eSpark-Consulting-Group/johncox-fmmdesign/docs/Client-Files/Enclosure-Catalogs/Baxin Catalog Pg 1.jpg

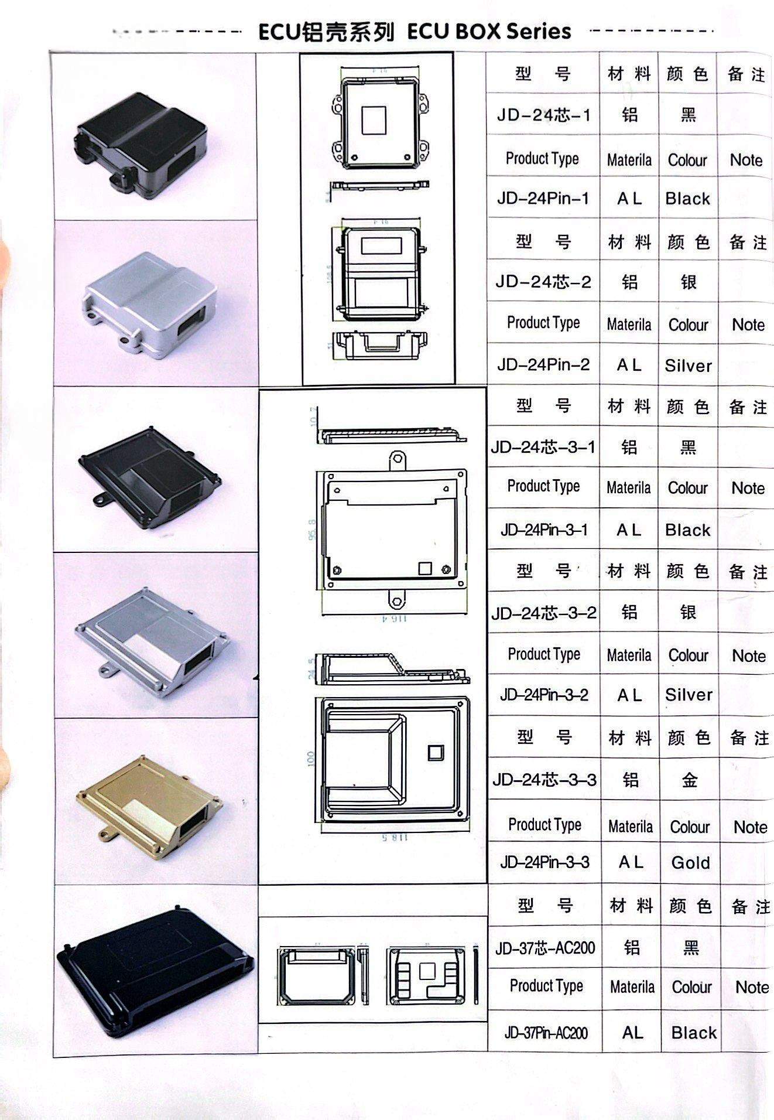
docs/Client-Files/Enclosure-Catalogs/Baxin Catalog Pg 1.jpg
