eSpark-Consulting-Group/johncox-fmmdesign/docs/Dev-Files/FMM-Connector-Format/FMM Pinout Format.docx

Sensor / Purpose | Circuit Type | Pin
Fuel Flow Sensor Engine 1 Supply | +5v power | 23
| Flow signal | 24
| Temp signal | 25
| Ground | 26
Fuel Flow Sensor Engine 1 Return | +5v power | 27
| Flow signal | 28
| Temp signal | 29
| Ground | 30
Fuel Flow Sensor Engine 2 Supply | +5v power | 31
| Flow signal | 32
| Temp signal | 33
| Ground | 34
Fuel Flow Sensor Engine 2 Return | +5v power | 36
| Flow signal | 37
| Temp signal | 38
| Ground | 39
Tank Level Sensor 1 | Level Signal | 14
| GND | 15
Tank Level Sensor 2 | Level Signal | 16
| GND | 17
Tank Level Sensor 3 | Level Signal | 18
| GND | 19
Tank Level Sensor 4 | Level Signal | 20
| GND | 21
System Power | +12v | 1
| +12v | 2
| GND | 3
| GND | 4
USB Connections | VBUS | 6
| USB-P | 7
| USB-N | 8
| GND | 9
CAN Connections | CAN-P | 11
| CAN-N | 12
| IS-GND (Isolated) | 13
