eSpark-Consulting-Group/johncox-fmmdesign/Design-Files/FMM-v1.0/Renderings/2D_C_View.PNG

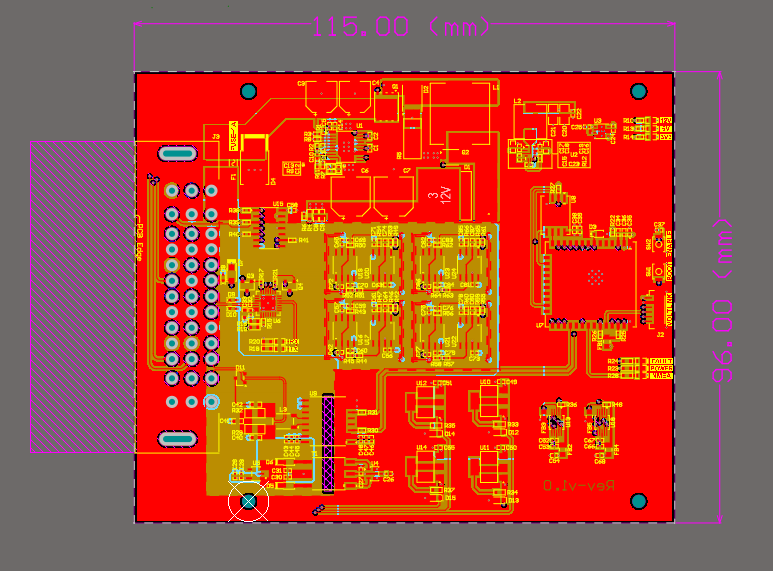
Design-Files/FMM-v1.0/Renderings/2D_C_View.PNG
