eSpark-Consulting-Group/johncox-fmmdesign/Design-Files/FMM-v1.0/Renderings/2D_Power_Layer.png

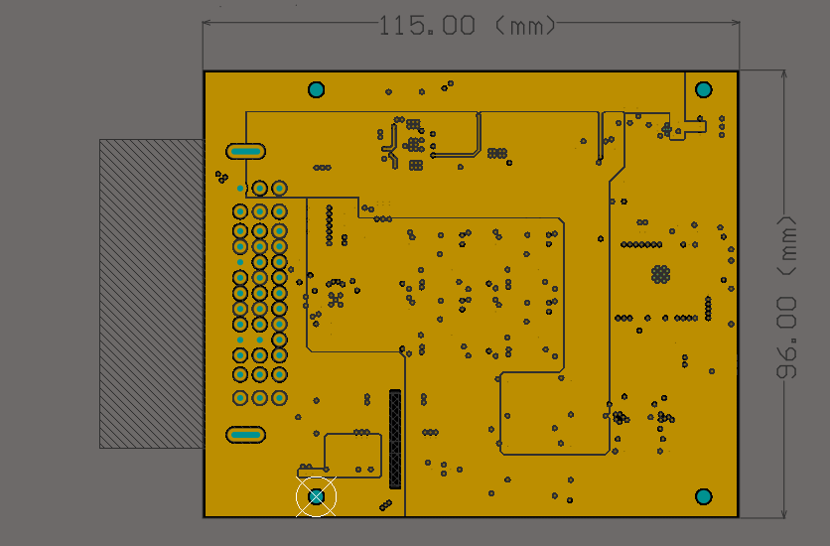
Design-Files/FMM-v1.0/Renderings/2D_Power_Layer.png
