eSpark-Consulting-Group/johncox-fmmdesign/Design-Files/FMM-v1.0/Renderings/2D_Top_Layer.PNG

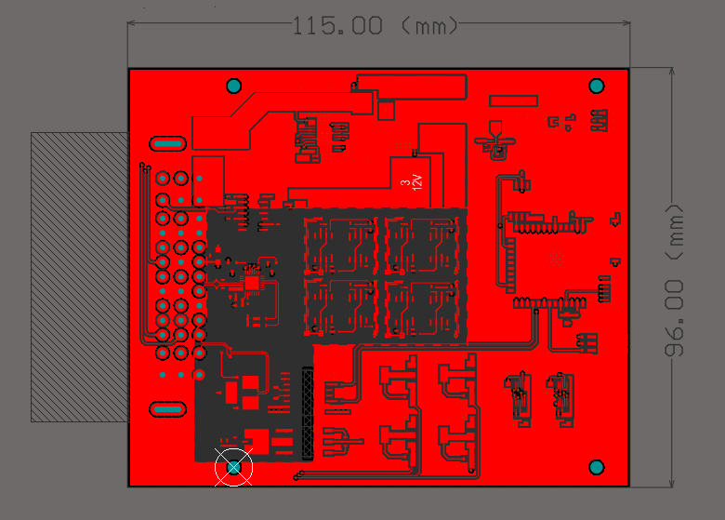
Design-Files/FMM-v1.0/Renderings/2D_Top_Layer.PNG
