eSpark-Consulting-Group/johncox-fmmdesign/Design-Files/FMM-v1.0/Renderings/3D_Bottom_View.PNG

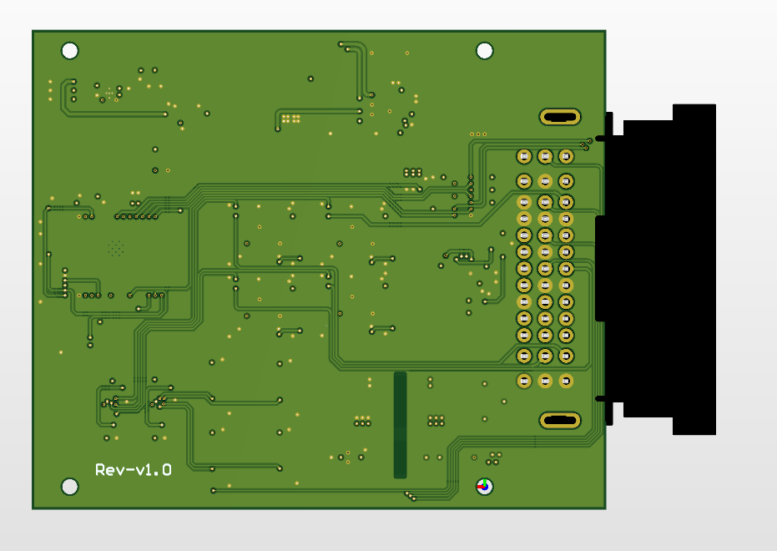
Design-Files/FMM-v1.0/Renderings/3D_Bottom_View.PNG
