eSpark-Consulting-Group/johncox-fmmdesign/docs/Dev-Files/Enclosure Files/Enclosure-PCB-Updated.png

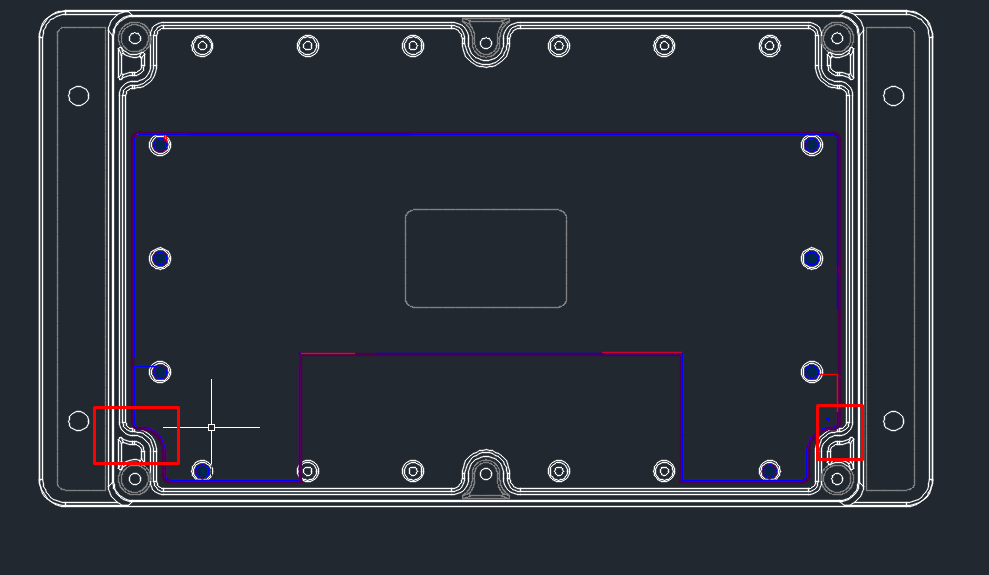
docs/Dev-Files/Enclosure Files/Enclosure-PCB-Updated.png
