eSpark-Consulting-Group/johncox-fmmdesign/docs/Dev-Files/Enclosure Files/imgpsh_fullsize_anim (2).png

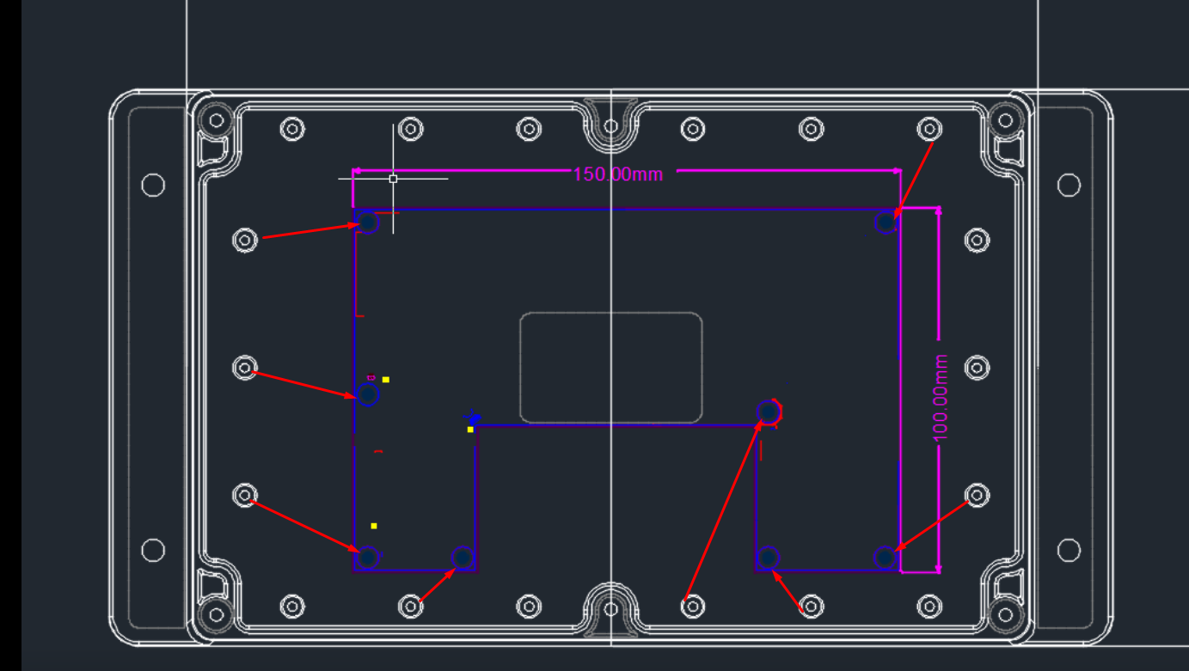
docs/Dev-Files/Enclosure Files/imgpsh_fullsize_anim (2).png
