eSpark-Consulting-Group/johncox-fmmdesign/docs/Dev-Files/Enclosure Files/imgpsh_fullsize_anim.png

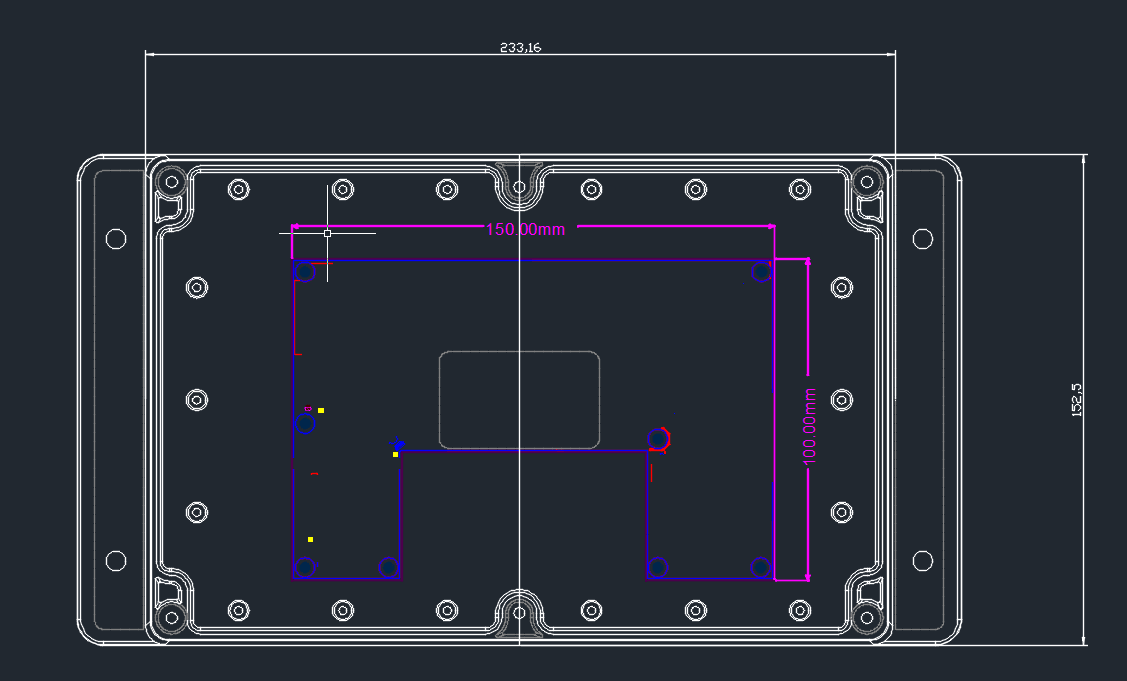
docs/Dev-Files/Enclosure Files/imgpsh_fullsize_anim.png
