eSpark-Consulting-Group/johncox-fmmdesign/docs/Dev-Files/Enclosure Files/John Casing.png

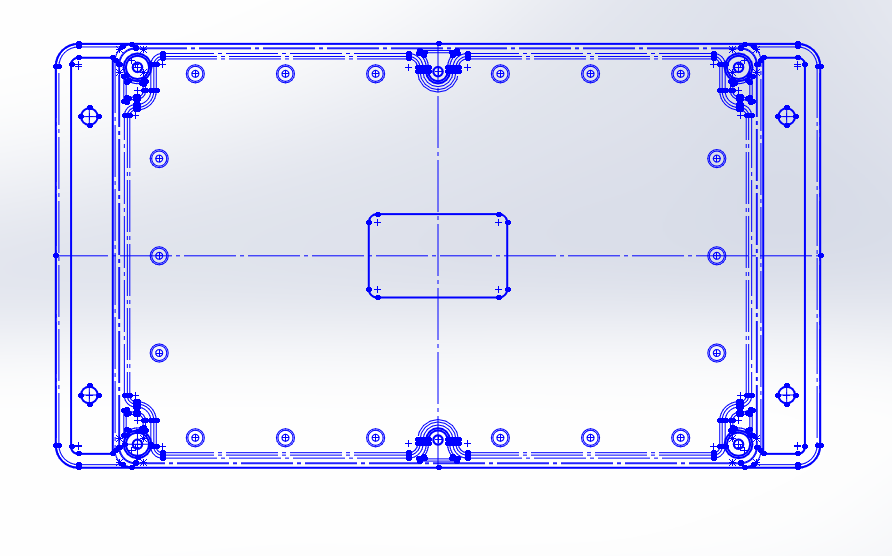
docs/Dev-Files/Enclosure Files/John Casing.png
