eSpark-Consulting-Group/johncox-fmmdesign/docs/Enclosure Files/Image.png

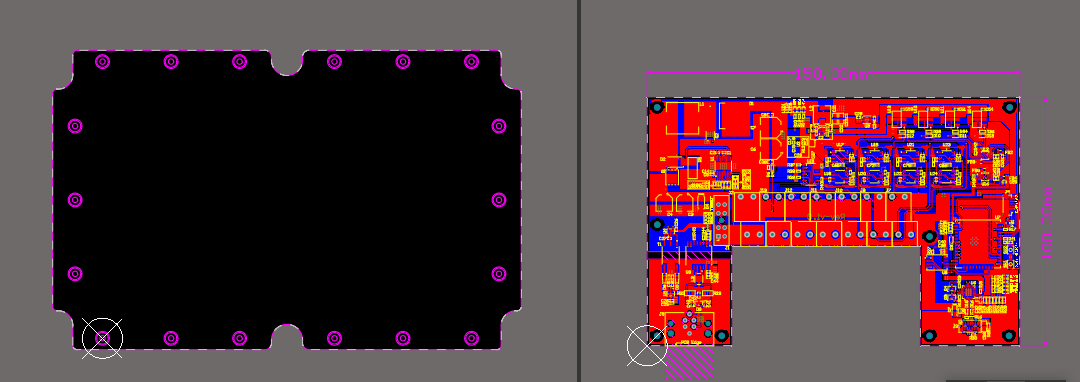
docs/Enclosure Files/Image.png
