eSpark-Consulting-Group/johncox-fmmdesign/docs/Enclosure Files/imgpsh_fullsize_anim (4).png

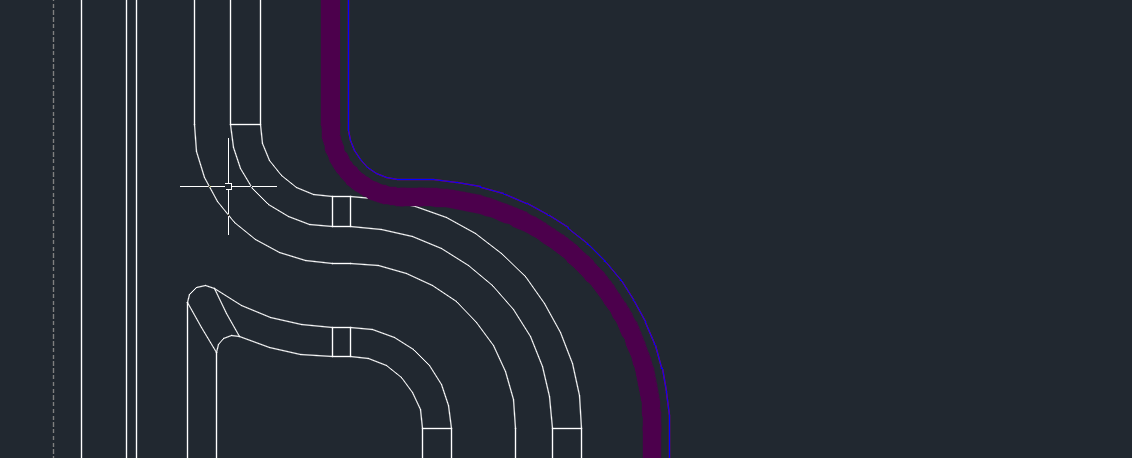
docs/Enclosure Files/imgpsh_fullsize_anim (4).png
