eSpark-Consulting-Group/johncox-fmmdesign/docs/Enclosure Files/SMA Space.png

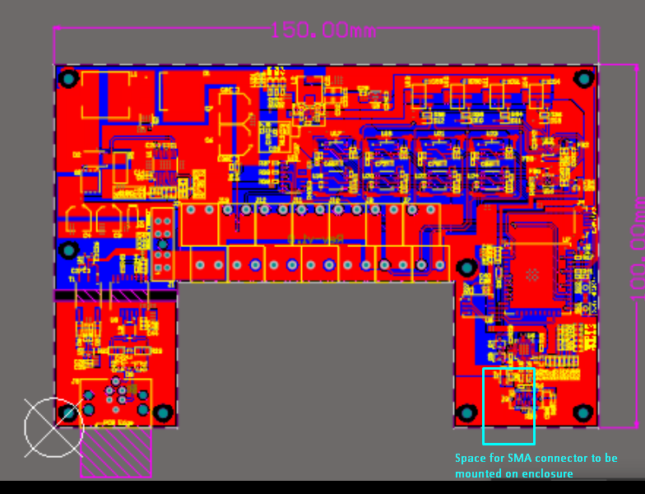
docs/Enclosure Files/SMA Space.png
