eSpark-Consulting-Group/johncox-fmmdesign/Design-Files/FMM-v1.0/BOM/eSpark-BOM-FMM-v1.0.xlsx

# | Item Type | Designator | Description | Footprint | Manufacturer Part Number | Manufacturer | Value | Quantity | 5 Boards Quantity | Link | Unit Price | 5 Boards Price | Remarks
1 | Capacitor | C1, C24, C32, C44, C47, C53, C54, C67, C68 | CAP CER 1UF 25V X5R 0402 | Cap-0402 | CL05A105KA5NQNC | Samsung | 1uF | 9 | 45 | Digikey (https://www.digikey.com/en/products/detail/samsung-electro-mechanics/CL05A105KA5NQNC/3887103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) | $0.12 | $5.58
2 | Capacitor | C2, C5, C14, C15, C18, C19, C22, C27, C29, C31, C34, C36, C37, C38, C45, C48, C49, C50, C51, C52, C55, C56, C57, C58, C63, C65, C66, C73, C75, C81, C82 | CAP CER 0.1UF 50V X7R 0402 | Cap-0402 | CL05B104KB54PNC | Samsung | 0.1uF | 31 | 155 | Digikey (https://www.digikey.com/en/products/detail/samsung-electro-mechanics/CL05B104KB54PNC/11487801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) | $0.02 | $3.01
3 | Capacitor | C3, C4 | CAP ALUM POLY 10UF 20% 50V SMD | Custom | 50SVPF10M | Panasonic | 10uF | 2 | 10 | Digikey (https://www.digikey.com/en/products/detail/panasonic-electronic-components/50SVPF10M/4209237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) | $0.92 | $9.21
4 | Capacitor | C6, C7 | CAP ALUM POLY 100UF 20% 25V SMD | Custom | 25SVPF100M | Panasonic | 100uF | 2 | 10 | Digikey (https://www.digikey.com/en/products/detail/panasonic-electronic-components/25SVPF100M/4209272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) | $1.04 | $10.39
5 | Capacitor | C8, C9 | CAP CER 0.47UF 50V X7R 0603 | Cap-0603 | CC0603KRX7R9BB474 | Yageo | 470nF | 2 | 10 | Digikey (https://www.digikey.com/en/products/detail/yageo/CC0603KRX7R9BB474/12082403) | $0.22 | $2.20
6 | Capacitor | C10 | CAP CER 0.022UF 50V X7R 0603 | Cap-0603 | CC0603KRX7R9BB223 | Yageo | 22nF | 1 | 5 | Digikey (https://www.digikey.com/en/products/detail/yageo/CC0603KRX7R9BB223/2103108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) | $0.10 | $0.50
7 | Capacitor | C11 | CAP CER 470PF 50V X7R 0603 | Cap-0603 | CC0603KPX7R9BB471 | Yageo | 470pF | 1 | 5 | Digikey (https://www.digikey.com/en/products/detail/yageo/CC0603KPX7R9BB471/691810) | $0.10 | $0.50
8 | Capacitor | C12 | CAP CER 0.047UF 25V X7R 0402 | Cap-0402 | GRM155R71E473KA88D | Murata | 47nF | 1 | 5 | Digikey (https://www.digikey.com/en/products/detail/murata-electronics/GRM155R71E473KA88D/702519) | $0.10 | $0.50
9 | Capacitor | C13 | CAP CER 1000PF 50V C0G/NP0 0402 | Cap-0402 | GRM1555C1H102JA01D | Murata | 1nF | 1 | 5 | Digikey (https://www.digikey.com/en/products/detail/murata-electronics/GRM1555C1H102JA01D/702509) | $0.10 | $0.50
10 | Capacitor | C16, C17, C33 | CAP CER 4.7UF 25V X5R 0603 | Cap-0603 | CL10A475KA8NQNC | Samsung | 4.7UF | 3 | 15 | Digikey (https://www.digikey.com/en/products/detail/samsung-electro-mechanics/CL10A475KA8NQNC/3887558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) | $0.23 | $3.39
11 | Capacitor | C20, C21 | CAP CER 47UF 25V X5R 1206 | Cap-1206 | GRM31CR61E476ME44L | Murata | 47uF | 2 | 10 | Digikey (https://www.digikey.com/en/products/detail/murata-electronics/GRM31CR61E476ME44L/7243446) | $0.74 | $7.37
12 | Capacitor | C23 | CAP CER 1UF 16V X5R 0402 | Cap-0402 | CC0402KRX5R7BB105 | Yageo | 1uF | 1 | 5 | Digikey (https://www.digikey.com/en/products/detail/yageo/CC0402KRX5R7BB105/5195100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) | $0.22 | $1.10
13 | Capacitor | C25, C26, C28, C30, C39, C43, C46 | CAP CER 10UF 10V X5R 0402 | Cap-0402 | CC0402MRX5R6BB106 | Yageo | 10uF | 7 | 35 | Digikey (https://www.digikey.com/en/products/detail/yageo/CC0402MRX5R6BB106/7164364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) | $0.26 | $9.10
14 | Capacitor | C35 | CAP CER 22UF 10V X5R 0402 | Cap-0402 | GRM158R61A226ME15D | Murata | 22uF | 1 | 5 | Digikey (https://www.digikey.com/en/products/detail/murata-electronics/GRM158R61A226ME15D/16033379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) | $0.45 | $2.25
15 | Capacitor | C40, C42 | CAP CER 68PF 100V C0G 0603 | Cap-0603 | CGA3E2C0G2A680JT0Y0N | TDK | 68pF | 2 | 10 | Digikey (https://www.digikey.com/en/products/detail/tdk-corporation/CGA3E2C0G2A680J080AA/3949573) | $0.12 | $1.19
16 | Capacitor | C41 | CAP CER 4700PF 50V C0G/NPO 0603 | Cap-0603 | CC0603JRNPO9BN472 | Yageo | 4.7nF | 1 | 5 | Digikey (https://www.digikey.com/en/products/detail/yageo/CC0603JRNPO9BN472/11491327) | $0.48 | $2.40
17 | Capacitor | C59, C60, C61, C69, C70, C71, C76, C77, C78, C83, C84, C85 | CAP CER 0.022UF 16V X7R 0402 | Cap-0402 | CC0402JRX7R7BB223 | Yageo | 22nF | 12 | 60 | Digikey (https://www.digikey.com/en/products/detail/yageo/CC0402JRX7R7BB223/5883287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) | $0.10 | $6.00
18 | Capacitor | C62, C72, C79, C86 | CAP CER 0.1UF 16V X7R 0402 | Cap-0402 | CC0402JRX7R7BB104 | Yageo | 0.1uF | 4 | 20 | Digikey (https://www.digikey.com/en/products/detail/yageo/CC0402JRX7R7BB104/5195085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) | $0.10 | $2.00
19 | Capacitor | C64, C74, C80, C87 | CAP CER 0.015UF 16V X7R 0402 | Cap-0402 | CC0402JRX7R7BB153 | Yageo | 15nF | 4 | 20 | Digikey (https://www.digikey.com/en/products/detail/yageo/CC0402JRX7R7BB153/5883285) | $0.10 | $2.00
20 | Diode | D1 | DIODE SCHOTTKY 100V 20A D2PAK | D2Pak. | STPS20M100SG-TR | STMicroelectronics | - | 1 | 5 | Digikey (https://www.digikey.com/en/products/detail/stmicroelectronics/STPS20M100SG-TR/2122461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) | $2.96 | $14.80
21 | Diode | D2 | DIODE SCHOTTKY 60V 7A POWERDI5 | Power-DI-5 | PDS760-13 | Diodes | - | 1 | 5 | Digikey (https://www.digikey.com/en/products/detail/diodes-incorporated/PDS760-13/776756) | $0.91 | $4.55
22 | Diode | D3 | DIODE ZENER 3.3V 200MW SOD323F | SOD323F | MM3Z3V3B | ON Semiconductor / Fairchild | - | 1 | 5 | Digikey (https://www.digikey.com/en/products/detail/onsemi/MM3Z3V3B/1626765?s=N4IgTCBcDaILJwMwC1EDVECEQF0C%2BQA) | $0.21 | $1.05
23 | Diode | D4 | TVS DIODE 30VWM 48.4VC SMC | SMC | 3.0SMCJ30AQ-13 | Diodes | - | 1 | 5 | Digikey (https://www.digikey.com/en/products/detail/diodes-incorporated/3-0SMCJ30A-13/1774300) | $1.08 | $5.40
24 | Diode | D5, D6 | DIODE SCHOTTKY 20V 500MA SOD123 | SOD-123 | MBR0520LT1G | ON Semiconductor | - | 2 | 10 | Digikey (https://www.digikey.com/en/products/detail/onsemi/MBR0520LT1G/918574?s=N4IgTCBcDaILICEBKAGArGFAZAKgRgHEQBdAXyA) | $0.26 | $2.55
25 | Diode | D7 | DIODE SCHOTTKY 30V 1A SOD123W | SOD-123W | PMEG3010ER,115 | Nexperia | - | 1 | 5 | Digikey (https://www.digikey.com/en/products/detail/nexperia-usa-inc/PMEG3010ER-115/2119868) | $0.41 | $2.05
26 | Protection Device | D8, D9, D10 | SOD-523 ESD Protection Devices ROHS | SOD-523 | LESD5D5.0CT1G | UMW | - | 3 | 15 | LCSC (https://www.lcsc.com/product-detail/Electrostatic-and-Surge-Protection-TVS-span-style-background-color-ff0-ESD-span_UMW-Youtai-Semiconductor-Co-Ltd-LESD5D5-0C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) | $0.02 | $0.23
27 | Surge Protection (TVS/ESD) | D11 | TVS DIODE 7V/12V 14V/26V SOT23-3 | SOT-23 | CDSOT23-SM712 | Bourns | - | 1 | 5 | Digikey (https://www.digikey.com/en/products/detail/bourns-inc/CDSOT23-SM712/1630592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) | $1.50 | $7.50
28 | TVS Diode | D12, D13, D14, D15 | TVS DIODE 3.3VWM 11.5VC MICROSMP | MicroSMP | MSP3V3HM3/89A | Vishay | - | 4 | 20 | Digikey (https://www.digikey.com/en/products/detail/vishay-general-semiconductor-diodes-division/MSP3V3HM3-89A/2149921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) | $0.27 | $5.38
29 | Fuse | F1 | 16V 1A 100A 1.8A 1206 Resettable Fuses ROHS | Fuse 1206 (3216 Metric) | BSMD1206-100-16V | BHFUSE | - | 1 | 10 | LCSC (https://www.lcsc.com/product-detail/Resettable-Fuses_BHFUSE-BSMD1206-100-16V_C883131.html) | $0.04 | $0.45
30 | Ferrite Bead | FB1, FB2, FB3, FB4, FB5 | FERRITE BEAD 1K OHM 0805 1LN | Ind-0805 | MMZ2012R102ATD25 | TDK | - | 5 | 25 | Digikey (https://www.digikey.com/en/products/detail/tdk-corporation/MMZ2012R102ATD25/5040278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) | $0.09 | $2.33
31 | Connector | J2 | 1x6P SH 1 1mm 6 SMD,P=1mm Wire To Board / Wire To Wire Connector ROHS | Custom | C145963 | BOOMELE | - | 1 | 5 | LCSC (https://www.lcsc.com/product-detail/Wire-To-Board-Wire-To-Wire-Connector_BOOMELE-Boom-Precision-Elec-C145963_C145963.html) | $0.07 | $0.34
32 | Connector | J3 | DJ7391-1.5/2.8-11 automotive male 39 pin pcb connector ecu connector | Custom | DJ7391-1.5/2.8-10 |  |  | 1 | 5 | Alibaba (https://www.alibaba.com/product-detail/DJ7391-1-5-2-8-11_60632257987.html) | $2.98 | $14.90
33 | Inductor | L1 | FIXED IND 8.2UH 10.5A 15.5 MOHM | Custom | SRP1265A-8R2M | Bourns | 8.2uH | 1 | 5 | Digikey (https://www.digikey.com/en/products/detail/bourns-inc/SRP1265A-8R2M/4876632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) | $1.56 | $7.80
34 | Inductor | L2 | FIXED IND 2.2UH 4.3A 18.98 MOHM | Custom | CLF7045T-2R2N-D | TDK | 2.2uH | 1 | 5 | Digikey (https://www.digikey.com/en/products/detail/tdk-corporation/CLF7045T-2R2N-D/3910344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) | $1.19 | $5.95
35 | Common Mode Filter | L3 | CMC 51UH 200MA 2LN 2.8KOHM SMD | Custom | ACT45B-510-2P-TL003 | TDK | - | 1 | 5 | Digikey (https://www.digikey.com/en/products/detail/tdk-corporation/ACT45B-510-2P-TL003/1950642) | $1.85 | $9.25
36 | LED | LED1, LED2, LED3, LED7 | RED LED 0603 Light Emitting Diodes | LED-0603 | NCD0603R3 | Foshan NationStar Optoelectronics | - | 4 | 20 | LCSC (https://www.lcsc.com/product-detail/Light-Emitting-Diodes-LED_Foshan-NationStar-Optoelectronics-NCD0603R3_C3151730.html) | $0.02 | $0.42
37 | LED | LED4, LED5 | yellow 0603 Light Emitting Diodes (LED) ROHS | LED-0603 | NCD0603Y2 | Foshan NationStar Optoelectronics | - | 2 | 10 | LCSC (https://www.lcsc.com/product-detail/Light-Emitting-Diodes-LED_Foshan-NationStar-Optoelectronics-NCD0603Y2_C89811.html) | $0.02 | $0.22
38 | LED | LED6 | Emerald 0603 Light Emitting Diodes (LED) ROHS | LED-0603 | NCD0603G2 | Foshan NationStar Optoelectronics | - | 1 | 5 | LCSC (https://www.lcsc.com/product-detail/Light-Emitting-Diodes-LED_Foshan-NationStar-Optoelectronics-NCD0603G2_C87326.html) | $0.02 | $0.11
39 | LED | LED8 | blue 0603 Light Emitting Diodes (LED) ROHS | LED-0603 | NCD0603B3 | Foshan NationStar Optoelectronics | - | 1 | 5 | LCSC (https://www.lcsc.com/product-detail/Light-Emitting-Diodes-LED_Foshan-NationStar-Optoelectronics-NCD0603B3_C158101.html) | $0.03 | $0.16
40 | MOSFET | Q1 | MOSFET N-CH 40V 15A/50A 8VSON | 8-VSONP (5x6) | CSD18504Q5A | Texas Instruments | - | 1 | 5 | Digikey (https://www.digikey.com/en/products/detail/texas-instruments/CSD18504Q5A/3478068) | $1.09 | $5.45
41 | Mosfet | Q2 | MOSFET N-CH 30V 20A/60A 8VSON | 8-VSON-CLIP (3.3x3.3) | CSD17309Q3 | Texas Instruments | - | 1 | 5 | Digikey (https://www.digikey.com/en/products/detail/texas-instruments/CSD17309Q3/2268970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) | $1.09 | $5.45
42 | Mosfet | Q3, Q4 | 25V 300mW 120@100mA,1V 1.5A NPN SOT-23 Bipolar Transistors - BJT ROHS | SOT-23 | SS8050-G | Jiangsu Changjing Electronics Technology | - | 2 | 10 | Digikey (https://www.digikey.com/en/products/detail/comchip-technology/SS8050-G/6138901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) | $0.20 | $2.00
43 | Resistor | R1 | RES SMD 34.8KOHM 0.1% 1/16W 0402 | Res-0402 | RT0402BRD0734K8L | Yageo | 34.8k | 1 | 5 | Digikey (https://www.digikey.com/en/products/detail/yageo/RT0402BRD0734K8L/1069222) | $0.15 | $0.75
44 | Resistor | R2 | RES SMD 1M OHM 1% 1/10W 0603 | Res-0603 | RC0603FR-071ML | Yageo | 1M | 1 | 5 | Digikey (https://www.digikey.com/en/products/detail/yageo/RC0603FR-071ML/726844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) | $0.10 | $0.50
45 | Resistor | R3 | RES SMD 12.1KOHM 0.1% 1/16W 0402 | Res-0402 | RT0402BRD0712K1L | Yageo | 12.1k | 1 | 5 | Digikey (https://www.digikey.com/en/products/detail/yageo/RT0402BRD0712K1L/1069019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) | $0.15 | $0.75
46 | Resistor | R4 | RES SMD 47K OHM 0.1% 1/10W 0603 | Res-0603 | RT0603BRD0747KL | Yageo | 47K | 1 | 5 | Digikey (https://www.digikey.com/en/products/detail/yageo/RT0603BRD0747KL/1072543) | $0.13 | $0.65
47 | Resistor | R5 | RES 0.01 OHM 1% 3W 2512 | RES-2512 | CRA2512-FZ-R010ELF | Bourns | 10mΩ | 1 | 5 | Digikey (https://www.digikey.com/en/products/detail/bourns-inc/CRA2512-FZ-R010ELF/1775029) | $0.64 | $3.20
48 | Resistor | R6 | RES SMD 1.6K OHM 0.1% 1/16W 0402 | Res-0402 | RT0402BRD071K6L | Yageo | 1.6K | 1 | 5 | Digikey (https://www.digikey.com/en/products/detail/yageo/RT0402BRD071K6L/1069110) | $0.15 | $0.75
49 | Resistor | R7 | RES SMD 8.66KOHM 0.1% 1/16W 0402 | Res-0402 | RT0402BRD078K66L | Yageo | 8.66k | 1 | 5 | Digikey (https://www.digikey.com/en/products/detail/yageo/RT0402BRD078K66L/1069421) | $0.15 | $0.75
50 | Resistor | R8 | RES SMD 21K OHM 0.1% 1/16W 0402 | Res-0402 | RT0402BRD0721KL | Yageo | 21k | 1 | 5 | Digikey (https://www.digikey.com/en/products/detail/yageo/RT0402BRD0721KL/1069128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) | $0.15 | $0.75
51 | Resistor | R9 | RES SMD 10K OHM 0.1% 1/16W 0402 | Res-0402 | RT0402BRD0710KL | Yageo | 10K | 1 | 5 | Digikey (https://www.digikey.com/en/products/detail/yageo/RT0402BRD0710KL/1068998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) | $0.15 | $0.75
52 | Resistor | R10 | RES 1.5K OHM 1% 1/16W 0402 | Res-0402 | RC0402FR-071K5L | Yageo | 1.5K | 1 | 5 | Digikey (https://www.digikey.com/en/products/detail/yageo/RC0402FR-071K5L/726519) | $0.10 | $0.50
53 | Resistor | R11, R38, R39, R40, R41 | RES 1K OHM 1% 1/16W 0402 | Res-0402 | RC0402FR-071KL | Yageo | 1K | 5 | 25 | Digikey (https://www.digikey.com/en/products/detail/yageo/RC0402FR-071KL/726513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) | $0.01 | $0.38
54 | Resistor | R12 | RES 100K OHM 1% 1/16W 0402 | Res-0402 | RC0402FR-07100KL | Yageo | 100K | 1 | 5 | Digikey (https://www.digikey.com/en/products/detail/yageo/RC0402FR-07100KL/726526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) | $0.10 | $0.50
55 | Resistor | R13 | RES 499 OHM 1% 1/16W 0402 | Res-0402 | RC0402FR-07499RL | Yageo | 499R | 1 | 5 | Digikey (https://www.digikey.com/en/products/detail/yageo/RC0402FR-07499RL/726623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) | $0.10 | $0.50
56 | Resistor | R14 | RES 240 OHM 1% 1/16W 0402 | Res-0402 | RC0402FR-07240RL | Yageo | 240R | 1 | 5 | Digikey (https://www.digikey.com/en/products/detail/yageo/RC0402FR-07240RL/2827564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) | $0.01 | $0.07
57 | Resistor | R15 | RES 2K OHM 1% 1/16W 0402 | Res-0402 | RC0402FR-072KL | YAGEO | 2K | 1 | 5 | Digikey (https://www.digikey.com/en/products/detail/yageo/RC0402FR-072KL/2827565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) | $0.10 | $0.50
58 | Resistor | R16 | RES 22.1K OHM 1% 1/10W 0603 | Res-0603 | RC0603FR-0722K1L | Yageo | 22.1K | 1 | 5 | Digikey (https://www.digikey.com/en/products/detail/yageo/RC0603FR-0722K1L/727058) | $0.10 | $0.50
59 | Resistor | R17, R21, R22, R27, R36, R48 | RES 10K OHM 1% 1/16W 0402 | Res-0402 | RC0402FR-0710KL | Yageo | 10K | 6 | 30 | Digikey (https://www.digikey.com/en/products/detail/yageo/RC0402FR-0710KL/726523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) | $0.01 | $0.45
60 | Resistor | R18, R20 | RES SMD 220 OHM 1% 1/10W 0603 | Res-0603 | RC0603FR-07220RL | Yageo | 220R | 2 | 10 | Digikey (https://www.digikey.com/en/products/detail/yageo/RC0603FR-07220RL/727061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) | $0.02 | $0.19
61 | Resistor | R19 | RES 47.5K OHM 1% 1/10W 0603 | Res-0603 | RC0603FR-0747K5L | Yageo | 47.5K | 1 | 5 | Digikey (https://www.digikey.com/en/products/detail/yageo/RC0603FR-0747K5L/727255) | $0.10 | $0.50
62 | Resistor | R23 | RES 49.9 OHM 1% 1/10W 0603 | Res-0603 | RC0603FR-0749R9L | Yageo | 49.9R | 1 | 5 | Digikey (https://www.digikey.com/en/products/detail/yageo/RC0603FR-0749R9L/727264) | $0.10 | $0.50
63 | Resistor | R24 | RES SMD 240 OHM 0.1% 1/10W 0603 | Res-0603 | RT0603BRD07240RL | Yageo | 240R | 1 | 5 | Digikey (https://www.digikey.com/en/products/detail/yageo/RT0603BRD07240RL/1072382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) | $0.14 | $0.70
64 | Resistor | R25, R26 | RES 4.7K OHM 1% 1/16W 0402 | Res-0402 | RC0402FR-074K7L | Yageo | 4.7K | 2 | 10 | Digikey (https://www.digikey.com/en/products/detail/yageo/RC0402FR-074K7L/2827563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) | $0.10 | $1.00
65 | Resistor | R28 | RES 22 OHM 1% 1/10W 0603 | Res-0603 | RC0603FR-0722RL | Yageo | 22R | 1 | 5 | Digikey (https://www.digikey.com/en/products/detail/yageo/RC0603FR-0722RL/727055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) | $0.10 | $0.50
66 | Resistor | R29, R32 | RES SMD 59 OHM 0.1% 1/4W 1206 | Res-1206 | RT1206BRD0759RL | Yageo | 59R | 2 | 10 | Digikey (https://www.digikey.com/en/products/detail/yageo/RT1206BRD0759RL/1079897) | $0.09 | $0.94
67 | Resistor | R30, R31 | RES 0 OHM JUMPER 1/16W 0402 | Res-0402 | RC0402FR-070RL | Yageo | 0R | 2 | 10 | Digikey (https://www.digikey.com/en/products/detail/yageo/RC0402FR-070RL/2827570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) | $0.01 | $0.11
68 | Resistor | R33, R34, R35, R37 | RES 120 OHM 1% 1/10W 0603 | Res-0603 | RC0603FR-07120RL | Yageo | 120R | 4 | 20 | Digikey (https://www.digikey.com/en/products/detail/yageo/RC0603FR-07120RL/726920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) | $0.02 | $0.38
69 | Resistor | R43, R50, R56, R62 | RES SMD 27K OHM 0.1% 1/16W 0402 | Res-0402 | RT0402BRE0727KL | Yageo | 27K | 4 | 20 | Digikey (https://www.digikey.com/en/products/detail/yageo/RT0402BRE0727KL/1069620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) | $0.16 | $3.20
70 | Resistor | R44, R45, R51, R52, R57, R58, R63, R64 | RES SMD 8.2K OHM 0.1% 1/16W 0402 | Res-0402 | RT0402BRD078K2L | Yageo | 8.2K | 8 | 40 | Digikey (https://www.digikey.com/en/products/detail/yageo/RT0402BRD078K2L/1069419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) | $0.16 | $6.40
71 | Resistor | R46, R47, R53, R54, R59, R60, R65, R66 | RES SMD 22.1KOHM 0.1% 1/16W 0402 | Res-0402 | RT0402BRD0722K1L | Yageo | 22.1K | 8 | 40 | Digikey (https://www.digikey.com/en/products/detail/yageo/RT0402BRD0722K1L/1069134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) | $0.16 | $6.40
72 | Switch | SW1, SW2 | SWITCH TACTILE SPST-NO 0.05A 12V | Custom | B3U-1000P | Omron | - | 2 | 10 | Digikey (https://www.digikey.com/en/products/detail/omron-electronics-inc-emc-div/B3U-1000P/1534338) | $0.98 | $9.83
73 | TRANSFORMER | T1 | TRANSFORMER 475UH SMD | Custom | 760390015 | Wurth Electronics | - | 1 | 5 | Digikey (https://www.digikey.com/en/products/detail/w%C3%BCrth-elektronik/760390015/3831267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) | $1.90 | $9.50
74 | IC | U1 | IC REG CTRLR BUCK 20TSSOP | 20-HTSSOP | LM25118Q1MHX/NOPB | TI National Semiconductor | - | 1 | 5 | Digikey (https://www.digikey.com/en/products/detail/texas-instruments/LM25118Q1MHX-NOPB/3640694) | $6.11 | $30.55
75 | IC | U2 | IC REG BUCK 5V 2A 12VQFN | 12-VQFN-HR (3x2) | LMR33620CQ5RNXRQ1 | Texas Instruments | - | 1 | 5 | Digikey (https://www.digikey.com/en/products/detail/texas-instruments/LMR33620CQ5RNXRQ1/9861491) | $2.41 | $12.05
76 | IC | U3 | IC REG LIN 3.3V 1A 8SON | 8-SON (3x3) | TLV76733QWDRBRQ1 | Texas Instruments | - | 1 | 5 | Digikey (https://www.digikey.com/en/products/detail/texas-instruments/TLV76733QWDRBRQ1/15856719) | $1.43 | $7.15
77 | IC | U4 | IC XFRMR DRVR NCH 350MA SOT23-5 | SOT-23-5 | SN6501QDBVRQ1 | Texas Instruments | - | 1 | 5 | Digikey (https://www.digikey.com/en/products/detail/texas-instruments/SN6501QDBVRQ1/4251770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) | $2.27 | $11.35
78 | IC | U5 | IC REG LINEAR 5V 150MA SOT23-5 | SOT-23-5 | TPS76350QDBVRQ1 | Texas Instruments | - | 1 | 5 | Digikey (https://www.digikey.com/en/products/detail/texas-instruments/TPS76350QDBVRQ1/1673245) | $1.16 | $5.80
79 | IC | U6 | Full Speed USB to UART Bridge USB 2.0 3.3V T/R Automotive 28-Pin QFN EP | 28-QFN (5x5)_ | CP2102N-A02-GQFN28R | Silicon Labs | - | 1 | 5 | Digikey (https://www.digikey.com/en/products/detail/silicon-labs/CP2102N-A02-GQFN28R/9863480) | $4.66 | $23.30
80 | IC | U7 | RF TXRX MOD BLUETOOTH U.FL SMD | Custom | ESP32-WROOM-32UE-N16 | Espressif Systems | - | 1 | 5 | Digikey (https://www.digikey.com/en/products/detail/espressif-systems/ESP32-WROOM-32UE-N16/11613145) | $3.00 | $15.00
81 | IC | U8 | 2.7V~3.6V 50MHz 1Gbit LGA-8(6x8) NAND FLASH ROHS | Custom | XTSD01GLGEAG | XTX | - | 1 | 5 | LCSC (https://www.lcsc.com/product-detail/NAND-FLASH_XTX-XTSD01GLGEAG_C558837.html) | $2.67 | $13.33
82 | IC | U9 | 1/1 Transceiver Half CAN 16-SOIC | SOIC-16-300mil | ISO1050DWR | Texas Instruments | - | 1 | 5 | Digikey (https://www.digikey.com/en/products/detail/texas-instruments/ISO1050DWR/2596853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) | $4.51 | $22.55
83 | IC | U10, U11, U12, U14 | IC REG LIN POS ADJ 500MA SOT223 | SOT- 223 | LM317MDCYR | Texas Instruments | - | 4 | 20 | Digikey (https://www.digikey.com/en/products/detail/texas-instruments/LM317MDCYR/454187) | $0.68 | $13.60
84 | IC | U13, U18 | IC ADC 16BIT SIGMA-DELTA 10VSSOP | VSSOP-10 | ADS1115IDGSR | Texas Instruments | - | 2 | 10 | Digikey (https://www.digikey.com/en/products/detail/texas-instruments/ADS1115IDGSR/2231567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) | $5.29 | $52.88
85 | IC | U15 | IC INVERT SCHMITT 6CH 1IN 14SOIC | SOIC-14 | SN74HC14QDRQ1 | Texas Instruments | - | 1 | 5 | Digikey (https://www.digikey.com/en/products/detail/texas-instruments/SN74HC14QDRQ1/864250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) | $0.95 | $4.75
86 | IC | U16, U17, U19, U20, U21, U22, U23, U24 | IC OPAMP GP 1 CIRCUIT 8SOIC | SOIC-8(0.154", 3.90mm Width) | OPA350UA/2K5 | Texas Instruments |  | 8 | 40 | Digikey (https://www.digikey.com/en/products/detail/texas-instruments/OPA350UA-2K5/301257) | $2.98 | $119.20
87 | Peripheral | - | VoltLink CP2102N USB Serial Adapter & Programmer |  | Voltlink | Tinde | - | 1 | 2 | Tinde (https://www.tindie.com/products/voltlog/voltlink-cp2102n-usb-serial-adapter-programmer/) | $16.99 | $33.98
88 | Peripheral | - | 6.5cm IPEX to SMA 1Gen - Radio Frequency Cable ROHS | - | KHB65-37(11)-28-A/3 | Shenzhen Kinghelm Elec | - | 1 | 5 | LCSC (https://www.lcsc.com/product-detail/Radio-Frequency-Cable_Shenzhen-Kinghelm-Elec-KHB65-37-11-28-A-3_C2832000.html) | $0.73 | $3.67
89 | Peripheral | - | 3dBi - Antennas ROHS | - | HJ-2.4GHz 3dBi-SMA | HJ Tech | - | 1 | 5 | LCSC (https://www.lcsc.com/product-detail/Antennas_HJ-Tech-HJ-2-4GHz-5dBi-SMA_C1509154.html) | $1.25 | $6.23
 |  |  |  |  |  |  |  |  | 5 Boards Component Cost |  |  | $595.31
 |  |  |  |  |  |  |  |  | Single Board Cost |  |  | $119.06
