eSpark-Consulting-Group/johncox-fmmdesign/Design-Files/FMM-v1.0/FMM-v1.0.DXF

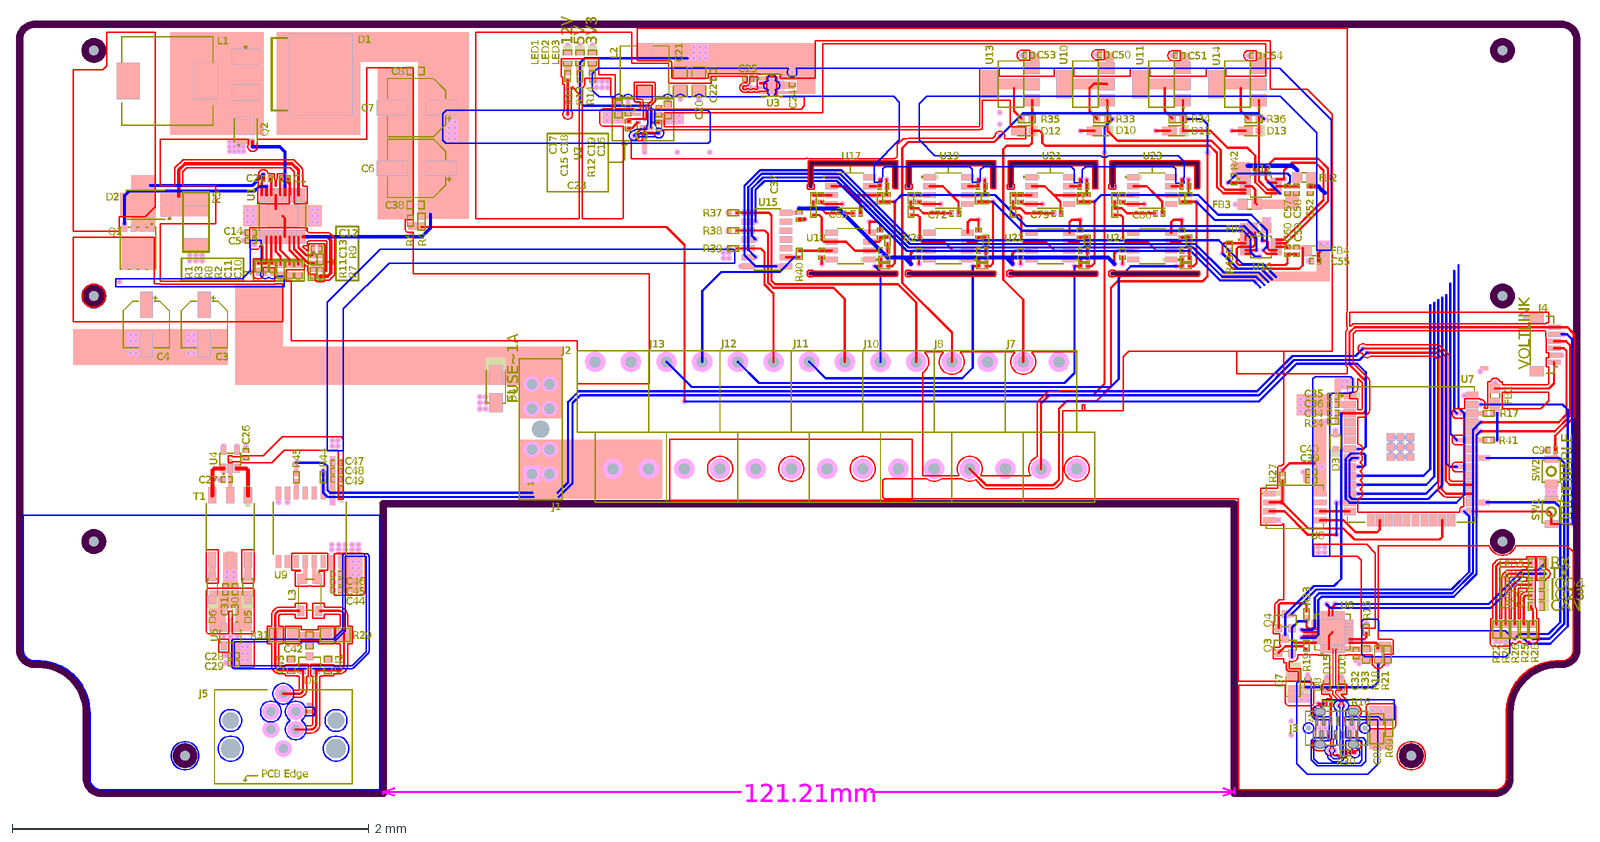
[picture p19: CAD file, 2024-03-28]
Design-Files/FMM-v1.0/FMM-v1.0.DXF
3V3
IO23
ENABLE
IO04
CAN
VOLTLINK
12V
FUSE~1A
RX
5V
BOOT
TX
121.21mm
R69
C88
U24
U23
U22
U21
U20
U19
U18
U17
C86
C79
C72
C65
R30
C37
J2
U7
C60
C59
C58
C57
U16
U15
U14
U13
U12
U11
U10
U9
U8
U6
U5
U4
U3
U2
U1
T1
SW2
SW1
R45
R44
R43
R42
R41
R40
R39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
