eSpark-Consulting-Group/johncox-fmmdesign/Design-Files/FMM-v1.0/Supporting Files/FMM-v1.0.DXF

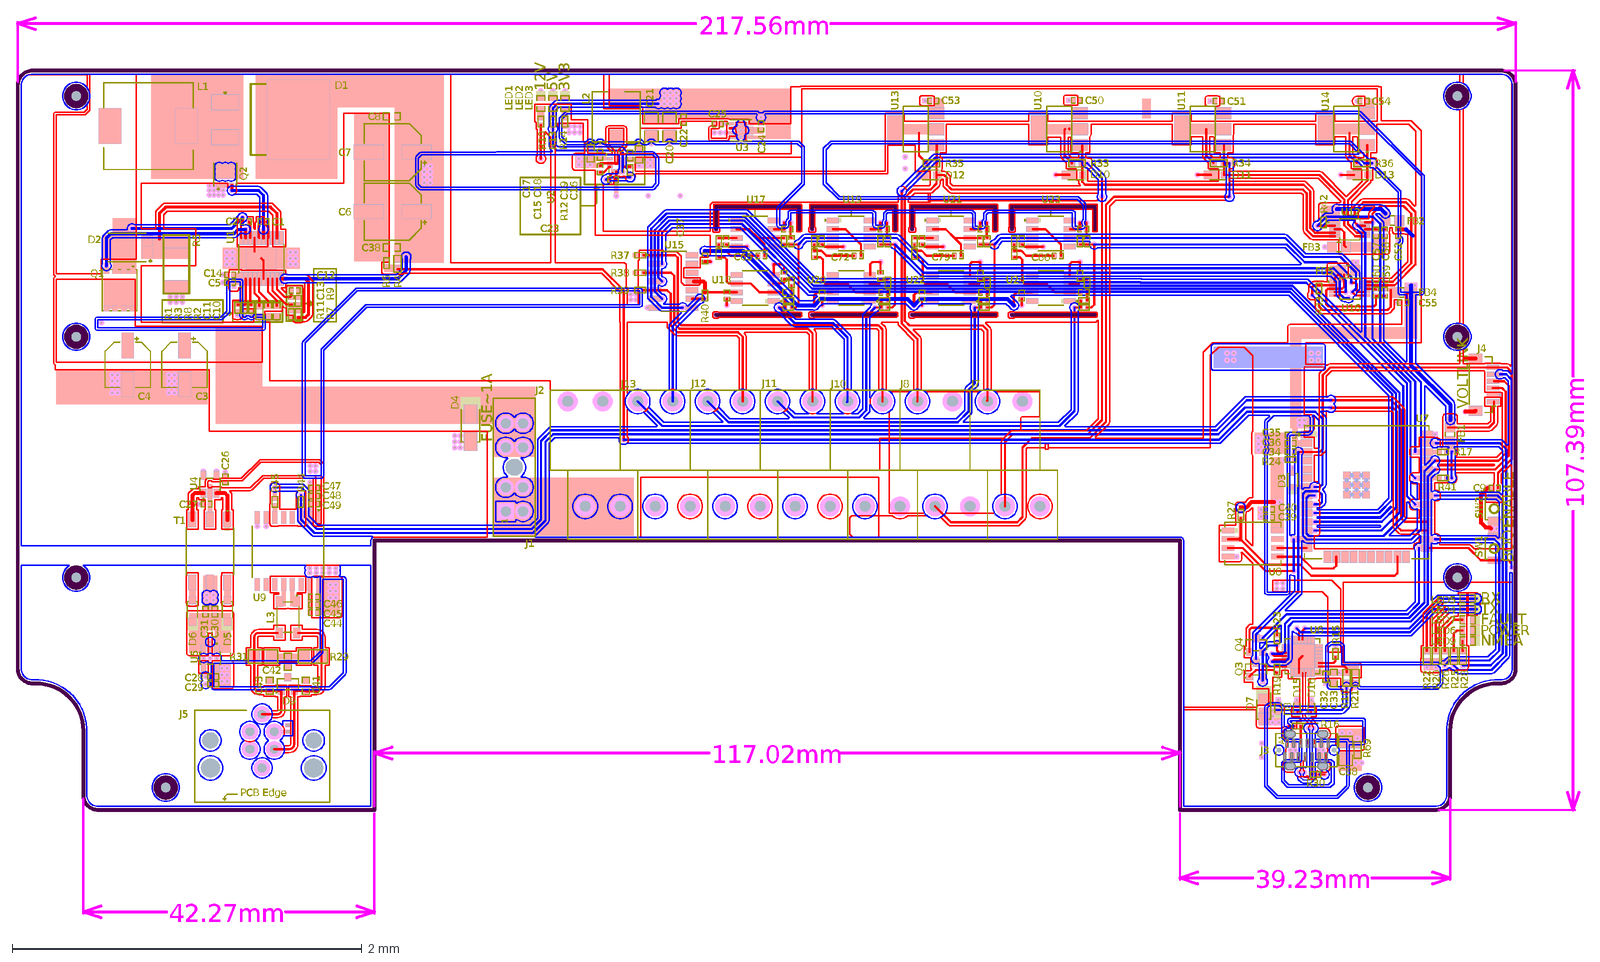
[picture p20: CAD file, 2024-03-29]
Design-Files/FMM-v1.0/Supporting Files/FMM-v1.0.DXF
BOOT
FAULT
12V
NMEA
5V
POWER
VOLTLINK
3V3
RX
TX
ENABLE
FUSE~1A
42.27mm
117.02mm
39.23mm
107.39mm
217.56mm
R69
C88
U24
U23
U22
U21
U20
U19
U18
U17
C86
C79
C72
C65
R30
C37
J2
U7
C60
C59
C58
C57
U16
U15
U14
U13
U12
U11
U10
U9
U8
U6
U5
U4
U3
U2
U1
T1
SW2
SW1
R45
R44
R43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
