eSpark-Consulting-Group/johncox-fmmdesign/docs/Enclosure Files/Test2.DXF

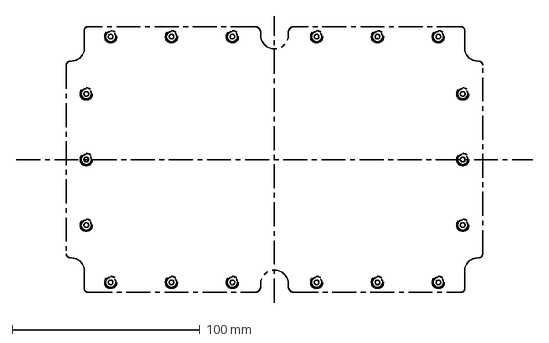
[picture p21: CAD file, 2024-03-27]
docs/Enclosure Files/Test2.DXF
275.0 x 152.5 mm
