eSpark-Consulting-Group/johncox-fmmdesign/(list of files, cad)

Other CAD files:
docs/Enclosure Files/enclosure-Hameed(1).dxf
Design-Files/FMM-v1.0/Supporting Files/FMM-v1.0.DWG
