eSpark-Consulting-Group/johncox-fmmdesign/Design-Files/FMM-v1.0/FMM-v1.0.pdf

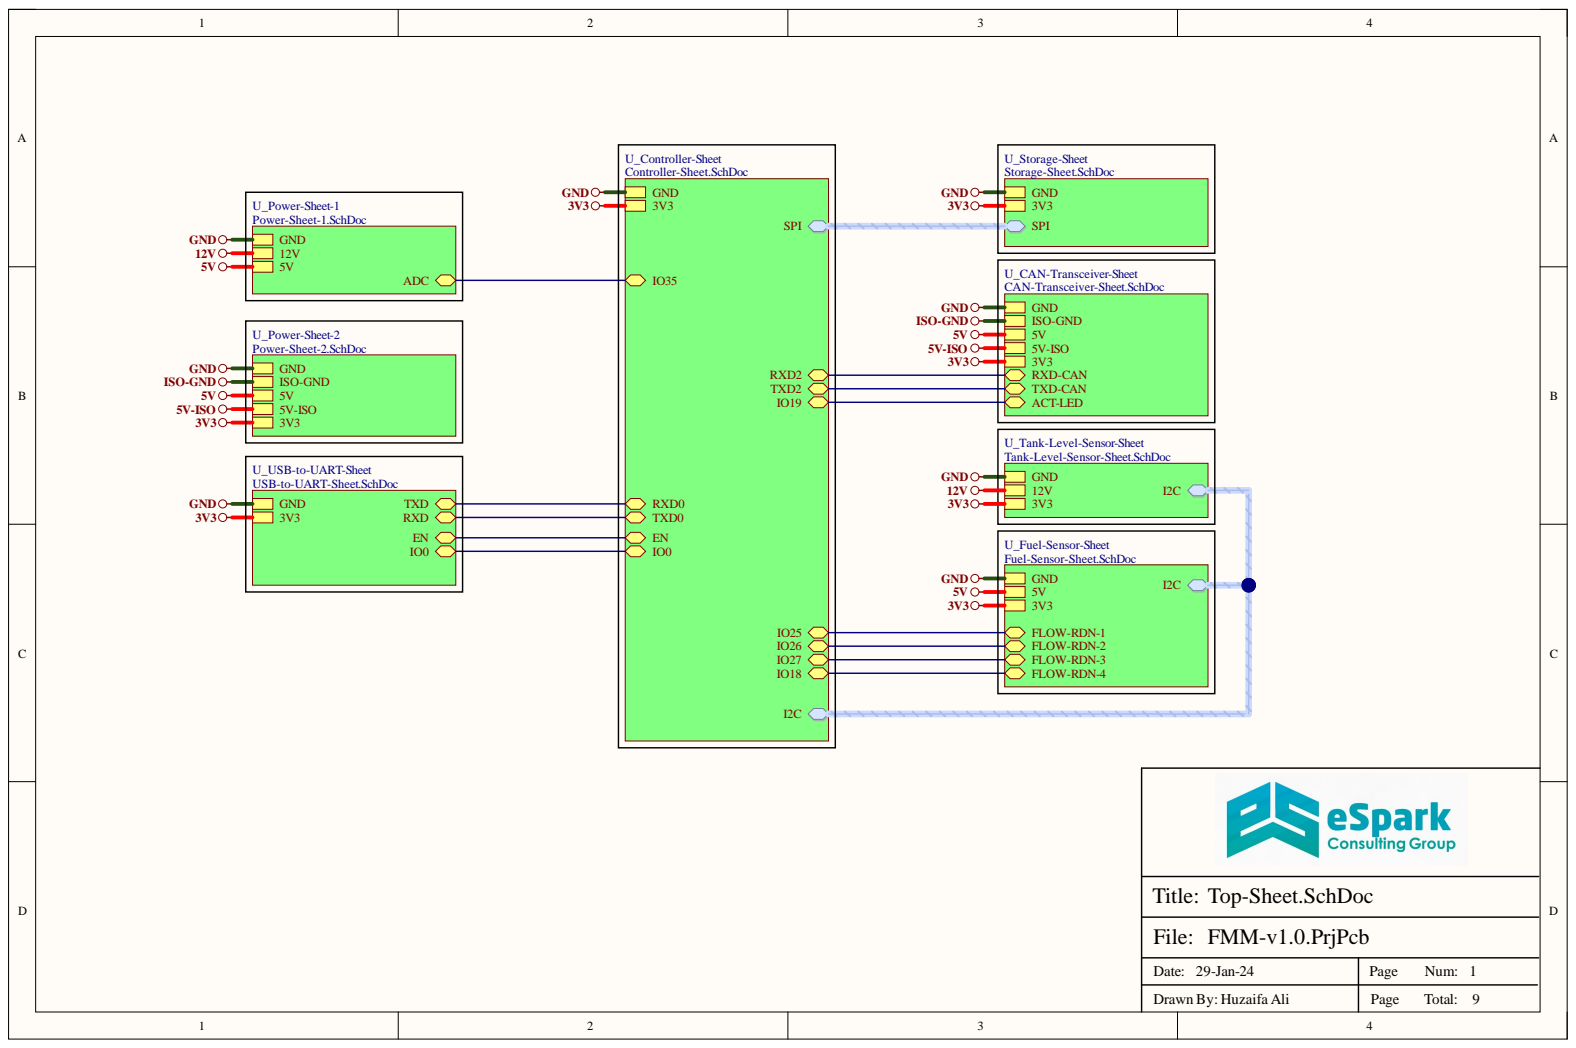
[picture p22: page 1]

ADC

RXD-CAN TXD-CAN ACT-LED

U_Tank-Level-Sensor-Sheet
Tank-Level-Sensor-Sheet.SchDoc
GND

U_USB-to-UART-Sheet
USB-to-UART-Sheet.SchDoc

Date: 29-Jan-24 | Page Num: 1

Drawn By: Huzaifa Ali | Page Total: 9

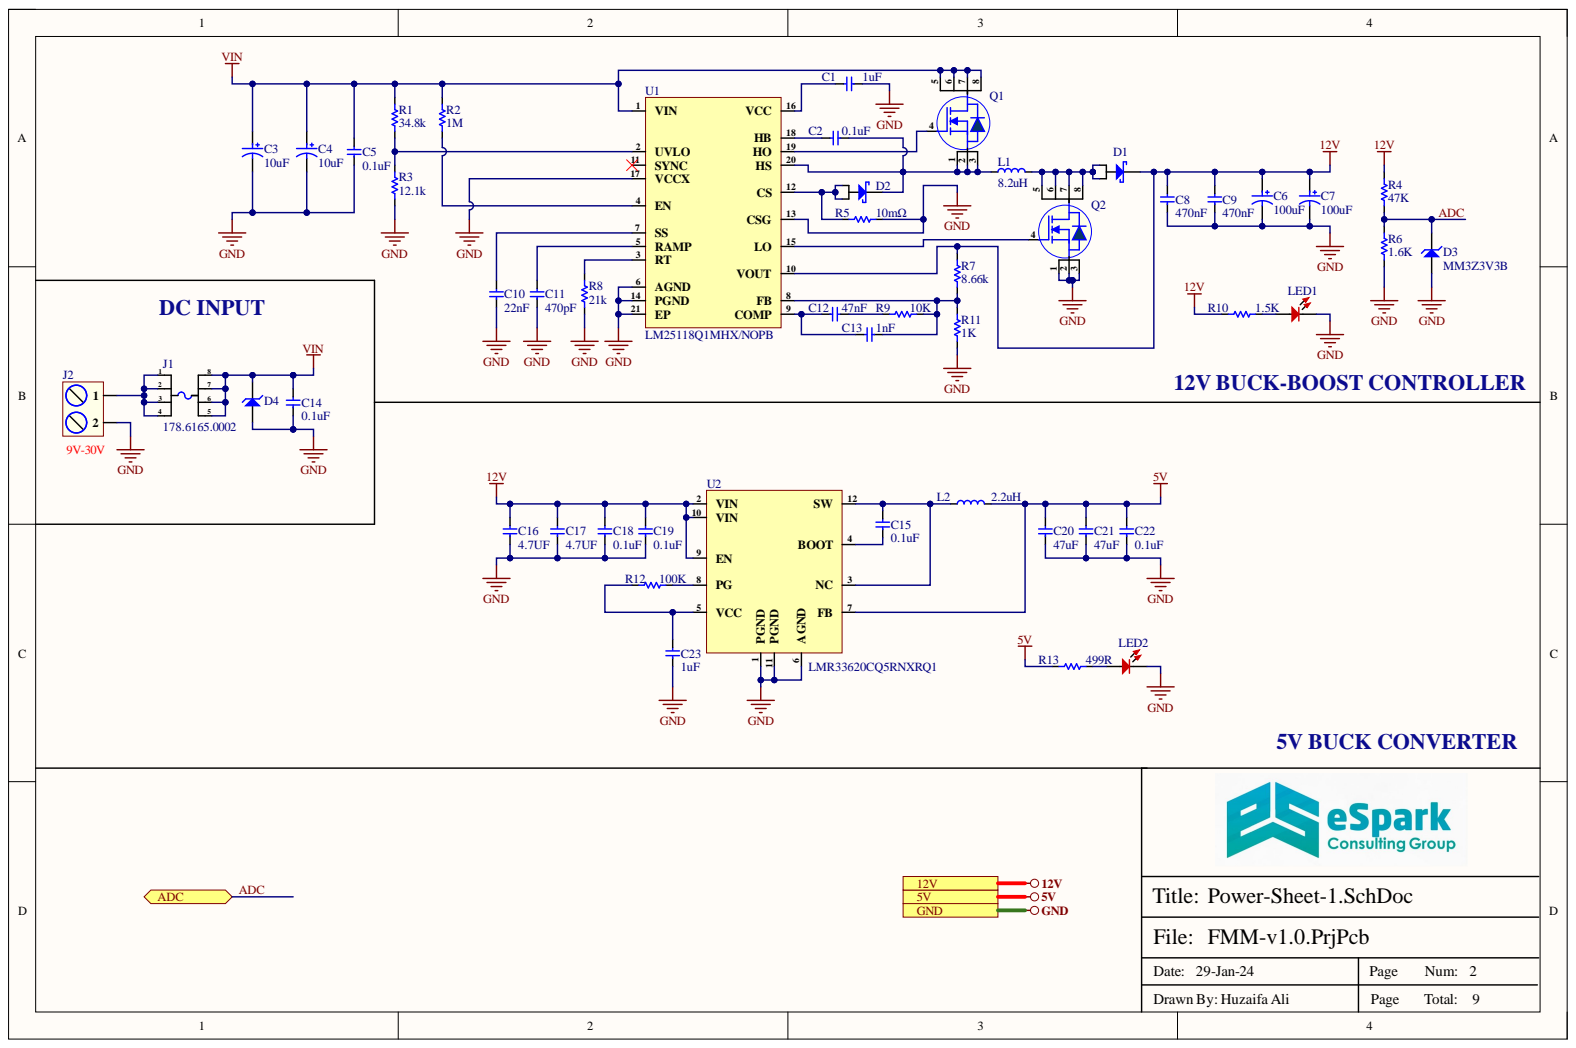
[picture p23: page 2]

Date: 29-Jan-24 | Page Num: 2

Drawn By: Huzaifa Ali | Page Total: 9

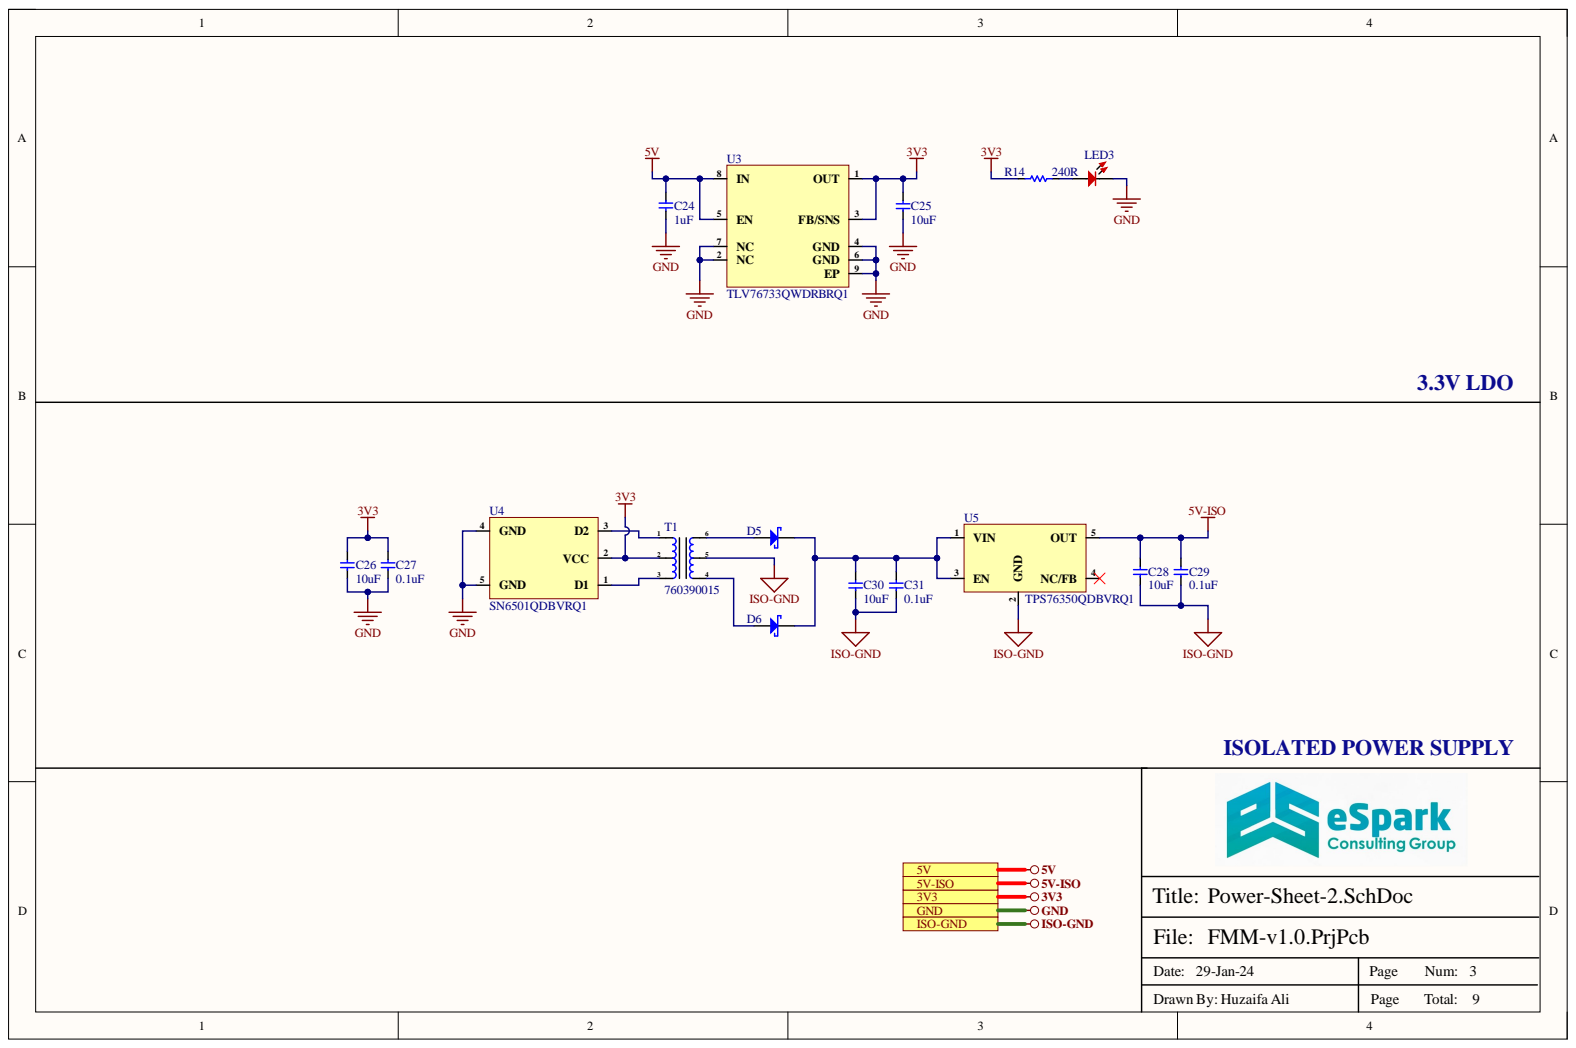
[picture p24: page 3]

Date: 29-Jan-24 | Page Num: 3

Drawn By: Huzaifa Ali | Page Total: 9

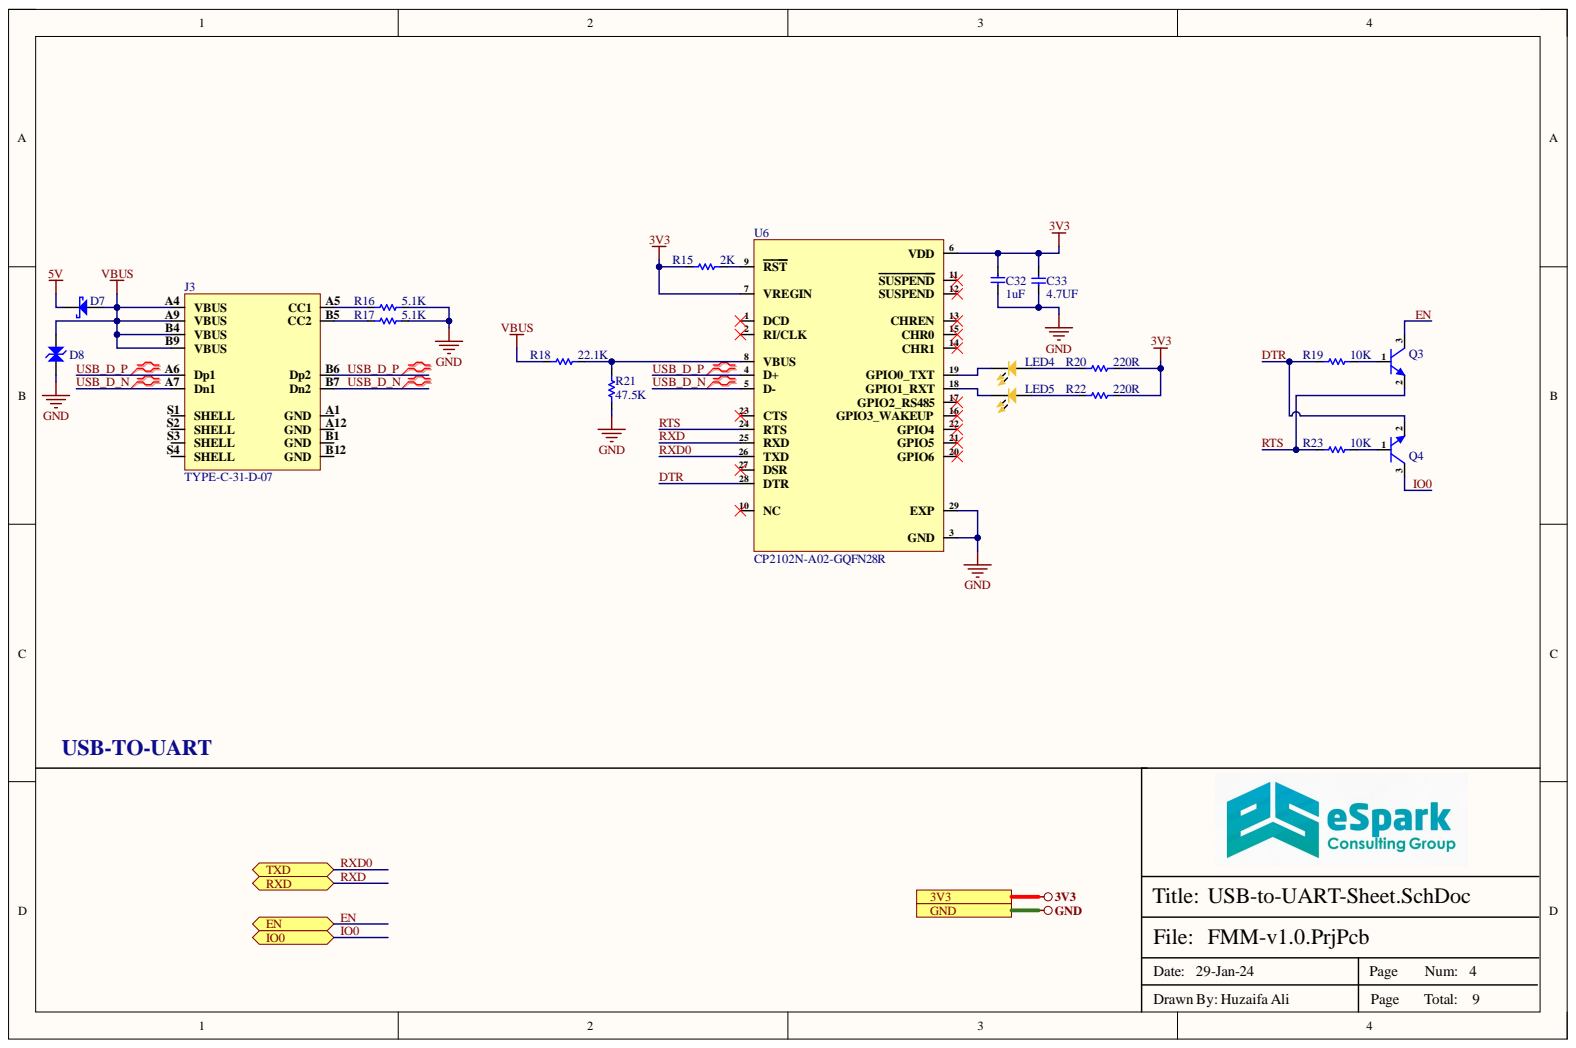
[picture p25: page 4]

TXD RXD0 RXD RXD EN EN IO0 IO0

USB-to-UART-Sheet.SchDoc

Date: 29-Jan-24 | Page Num: 4

Drawn By: Huzaifa Ali | Page Total: 9

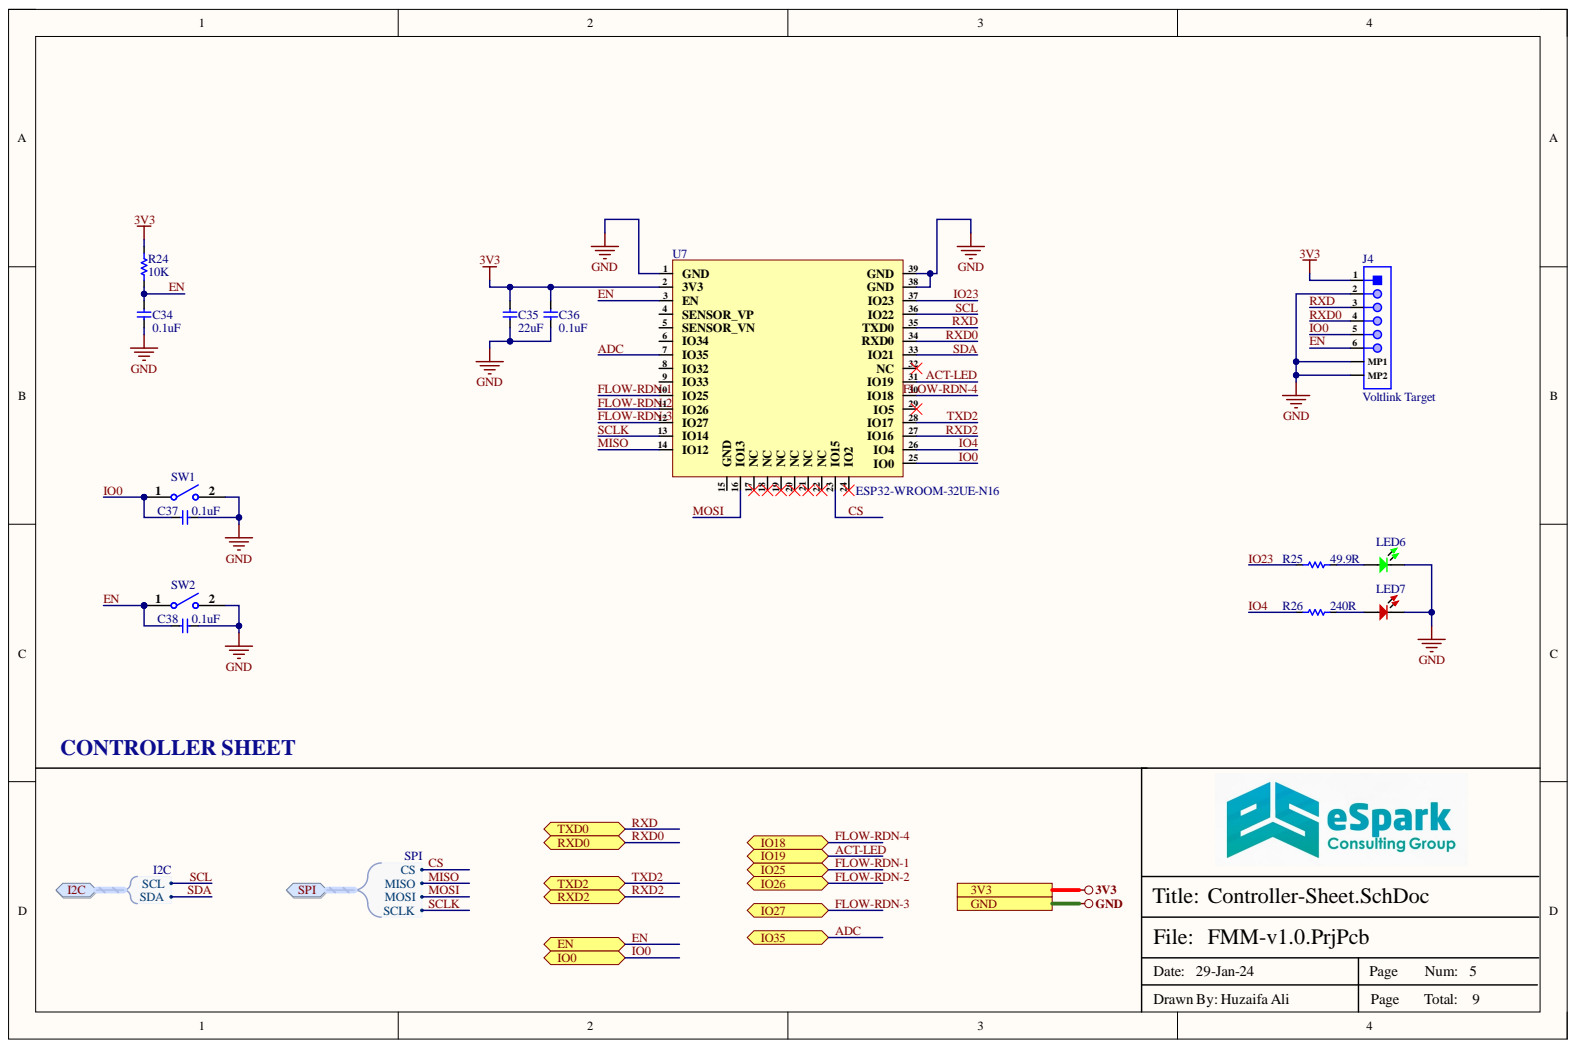
[picture p26: page 5]

TXD0 RXD RXD0 RXD0 IO18 FLOW-RDN-4 IO19 ACT-LED SPI CS IO25 FLOW-RDN-1 I2C CS SCL MISO TXD2 TXD2 IO26 FLOW-RDN-2 IO35 ADC EN EN IO0 IO0

Date: 29-Jan-24 | Page Num: 5

Drawn By: Huzaifa Ali | Page Total: 9

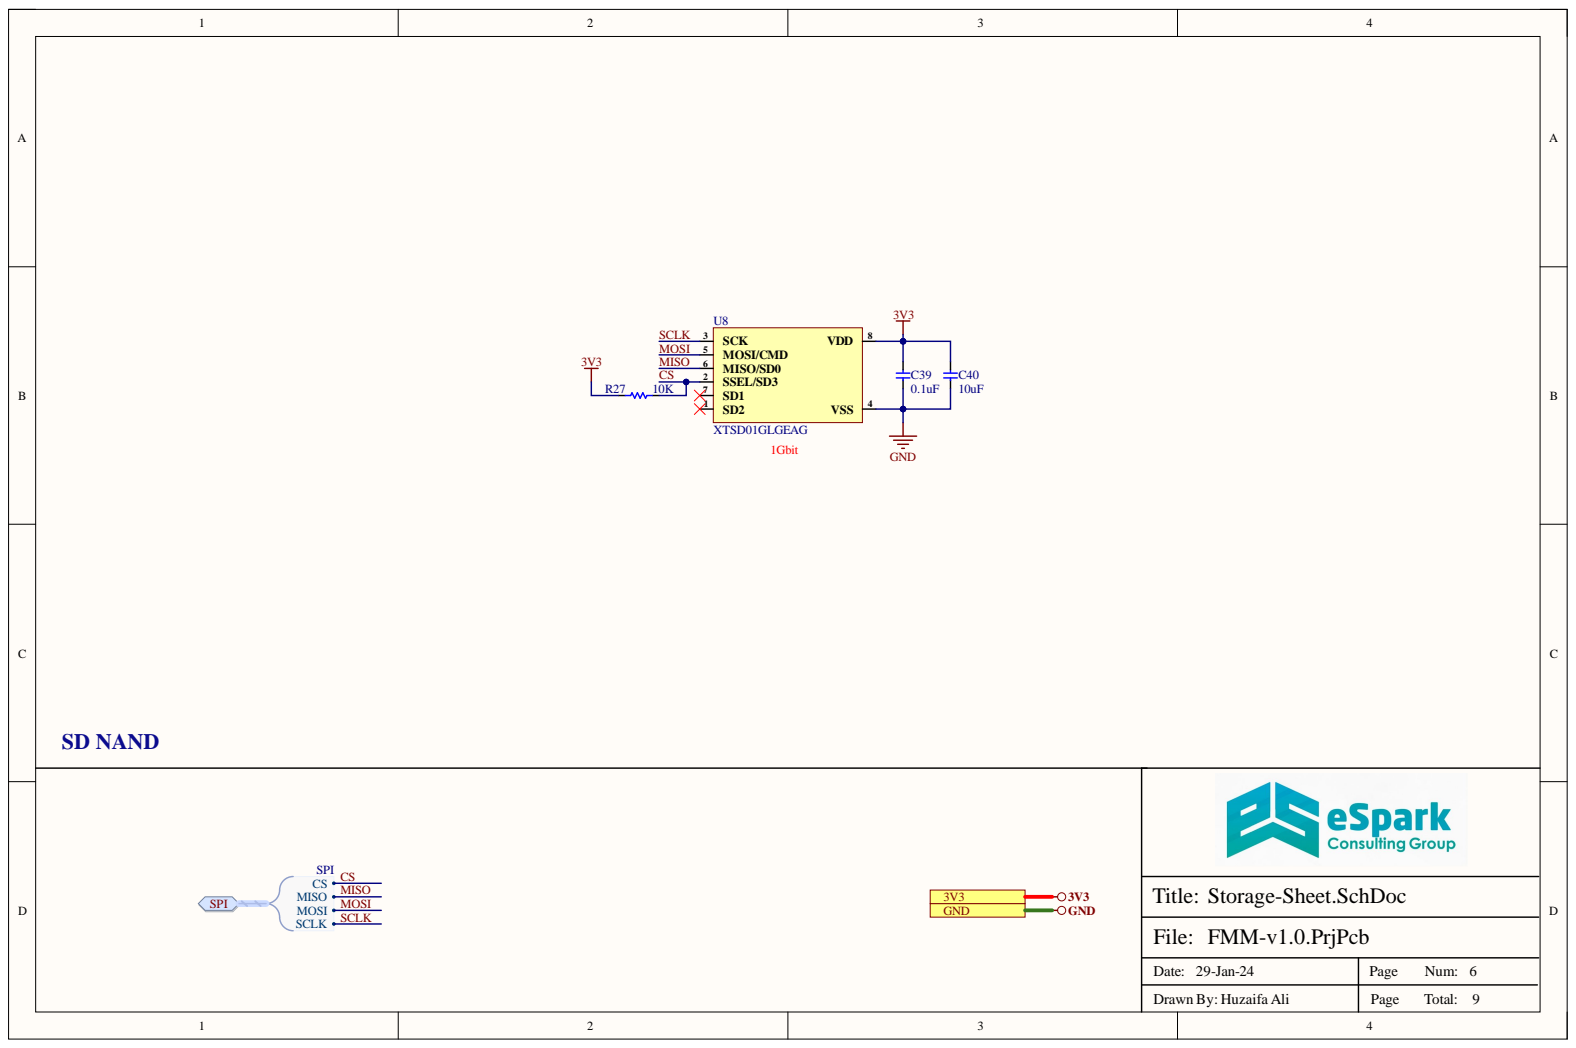
[picture p27: page 6]

SPI CS CS SCLK

Date: 29-Jan-24 | Page Num: 6

Drawn By: Huzaifa Ali | Page Total: 9

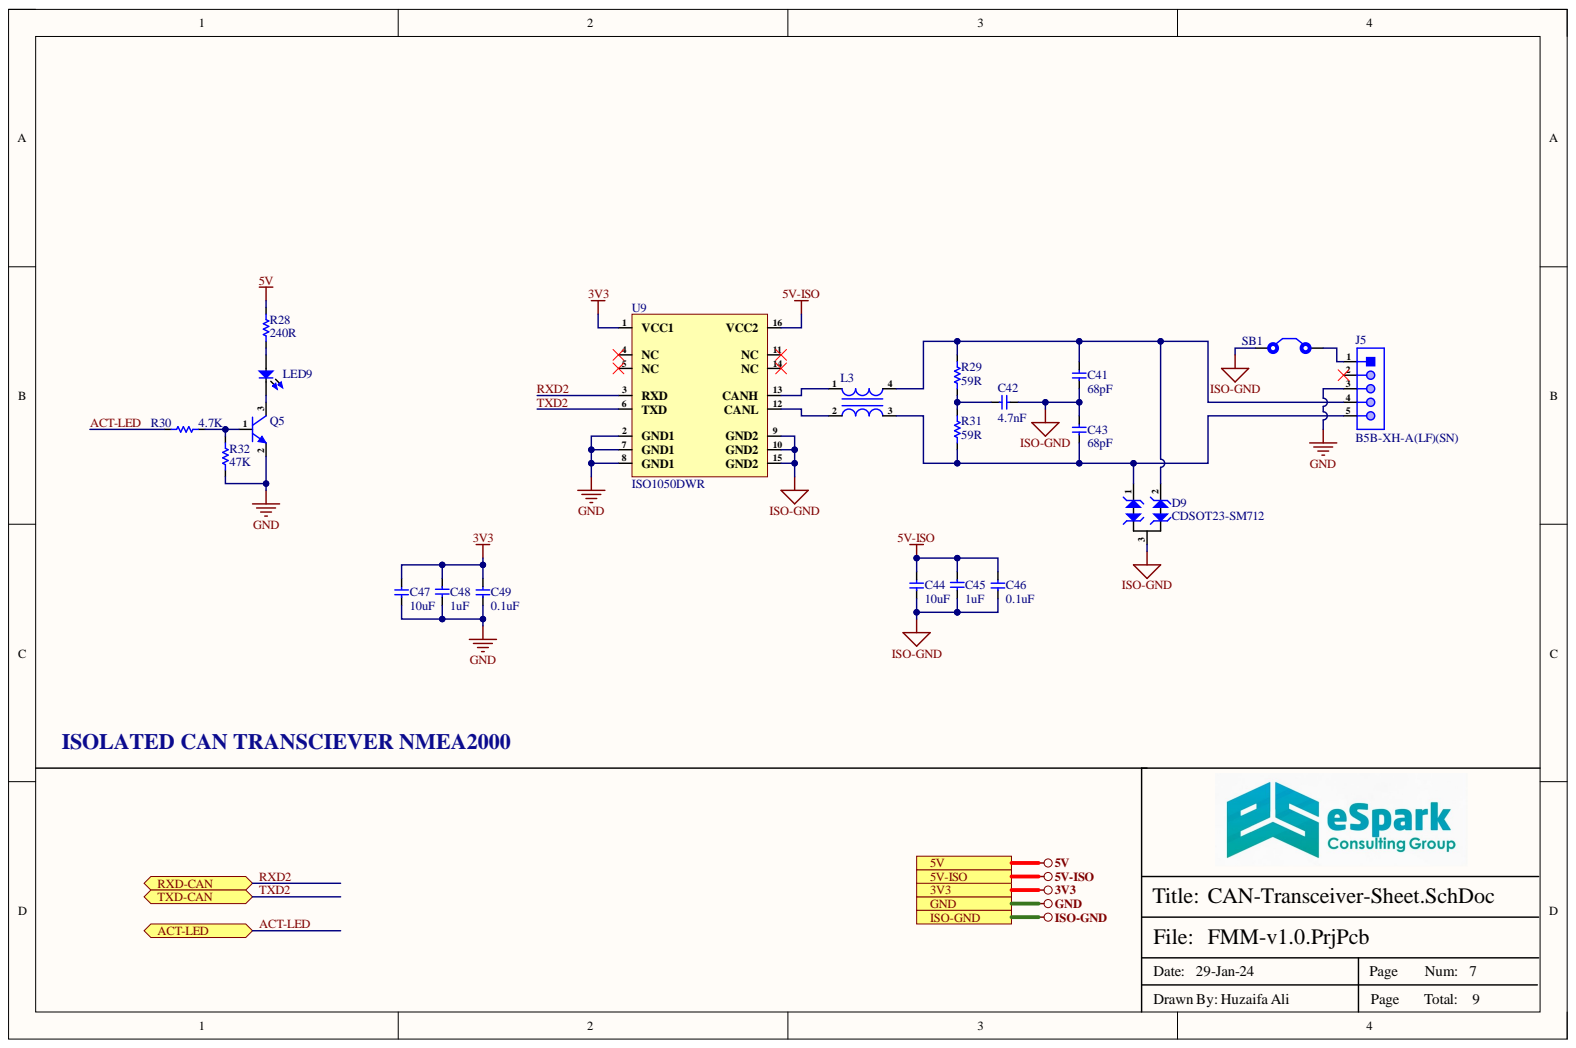
[picture p28: page 7]

CAN-Transceiver-Sheet.SchDoc

ACT-LED

Date: 29-Jan-24 | Page Num: 7

Drawn By: Huzaifa Ali | Page Total: 9

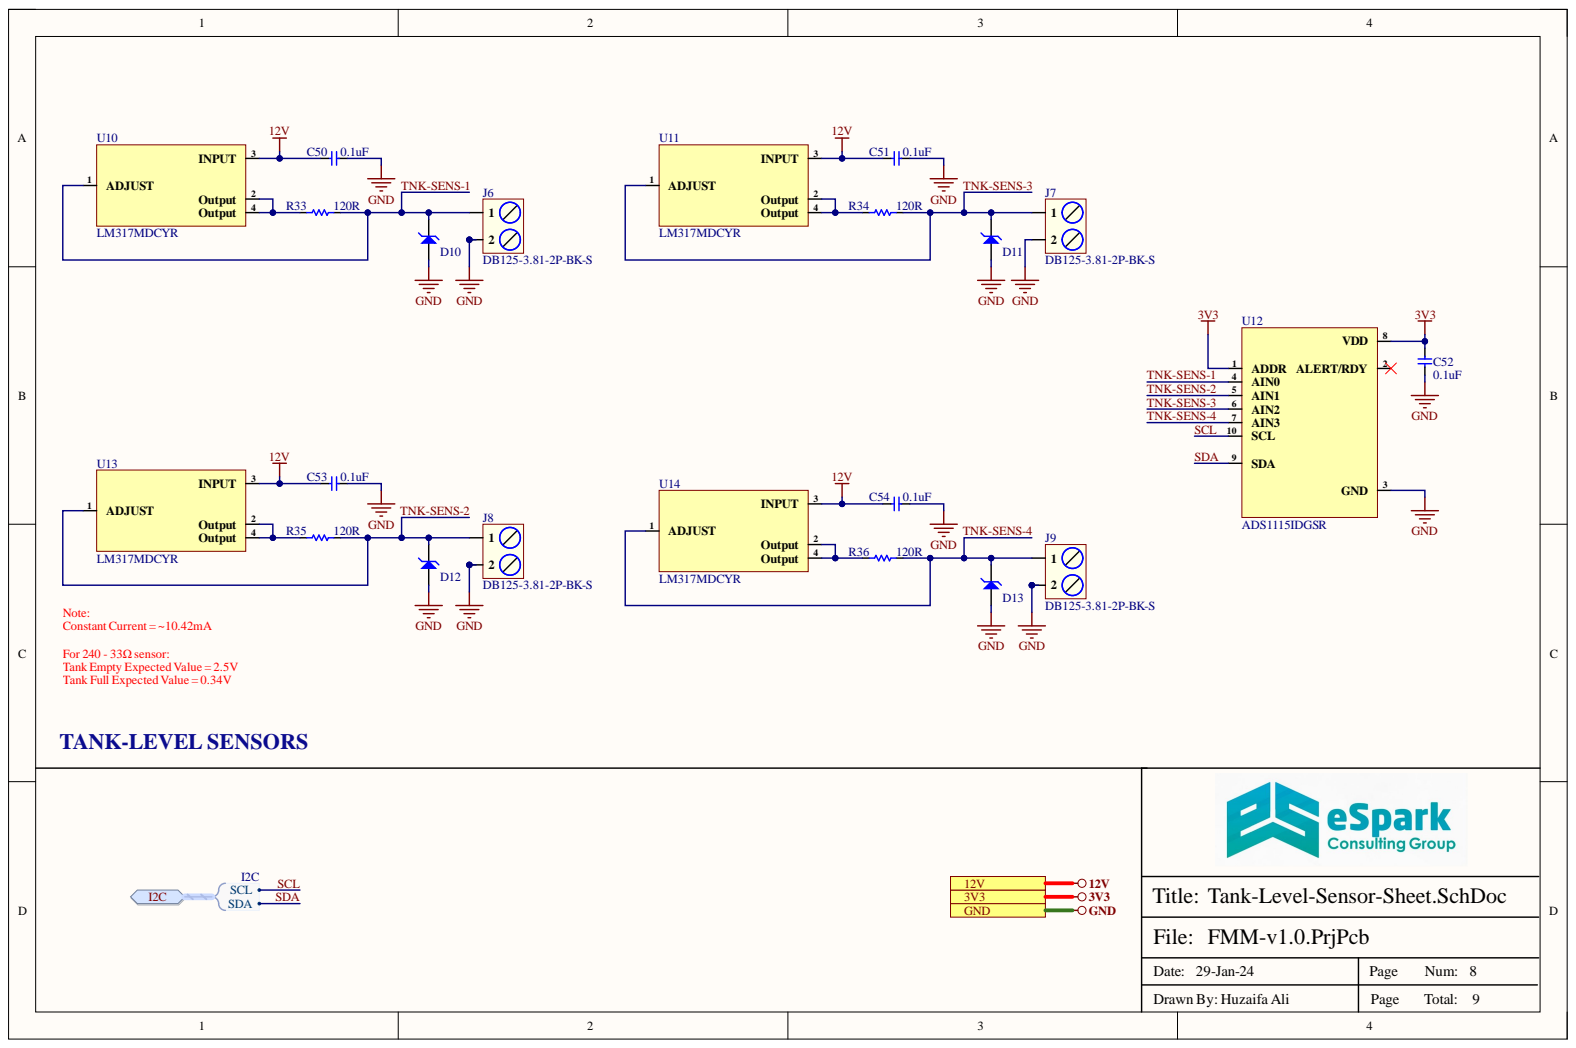
[picture p29: page 8]

For 240 - 33Ω sensor:
Tank Empty Expected Value = 2.5V
Tank Full Expected Value = 0.34V

Tank-Level-Sensor-Sheet.SchDoc

Date: 29-Jan-24 | Page Num: 8

Drawn By: Huzaifa Ali | Page Total: 9

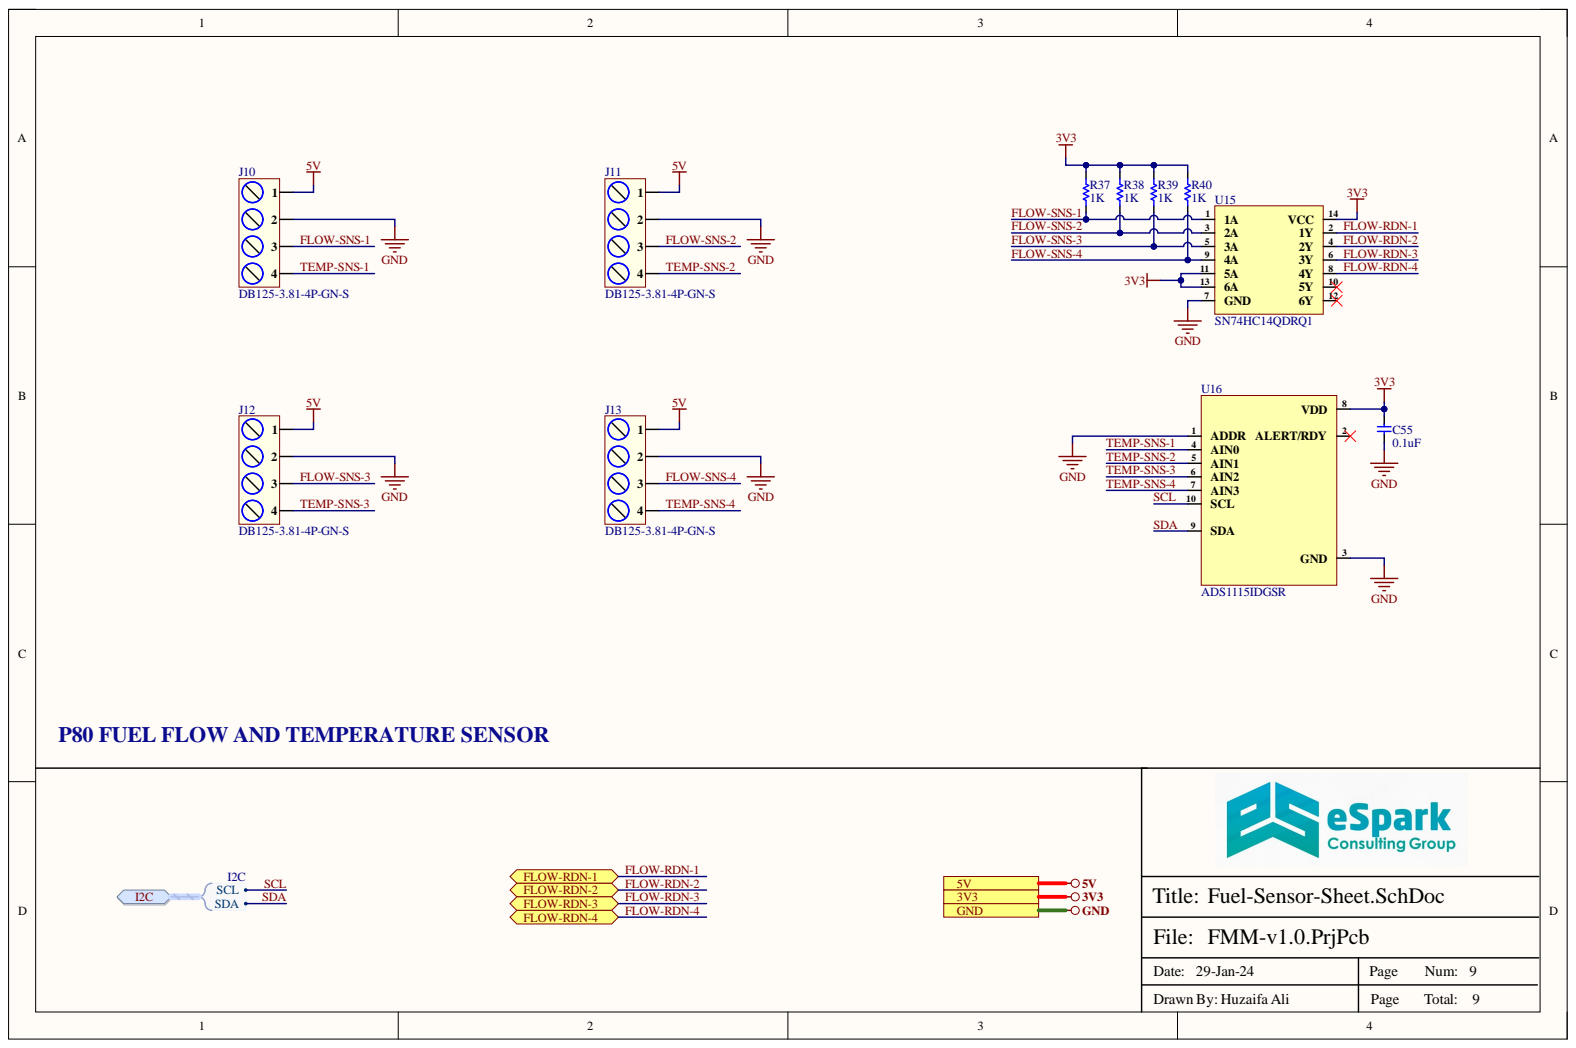
[picture p30: page 9]

P80 FUEL FLOW AND TEMPERATURE SENSOR

FLOW-RDN-1

Fuel-Sensor-Sheet.SchDoc

Date: 29-Jan-24 | Page Num: 9

Drawn By: Huzaifa Ali | Page Total: 9
