eSpark-Consulting-Group/johncox-fmmdesign/Design-Files/FMM-v1.0/Schematics/FMM-v1.0.pdf

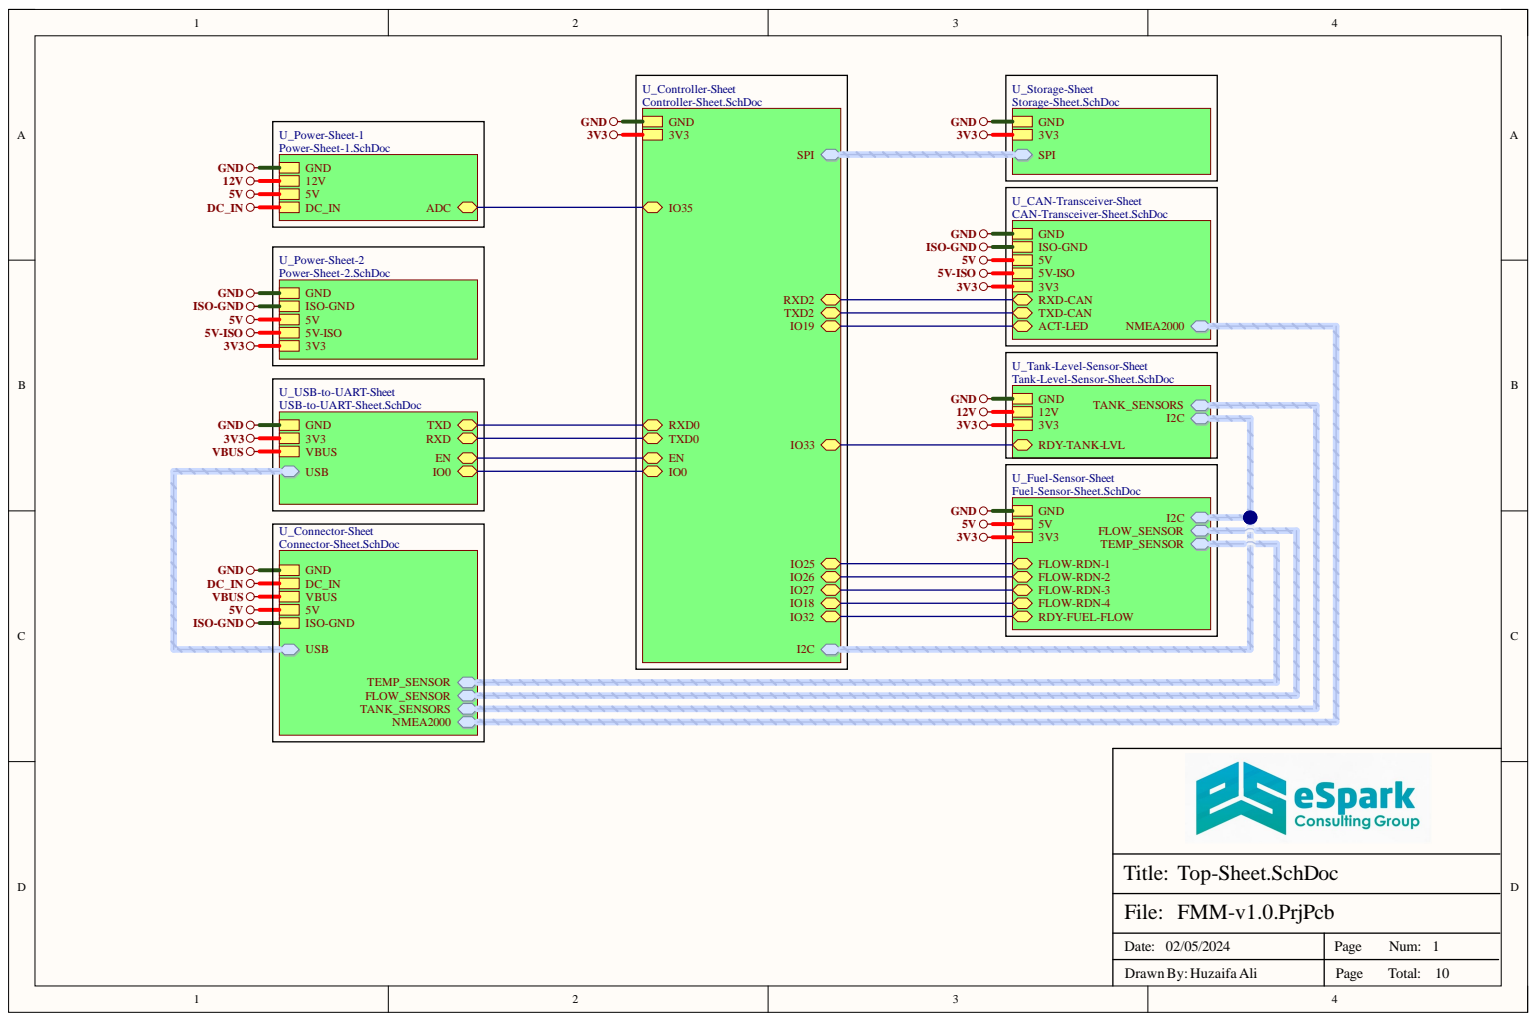
[picture p31: page 1]

U_Tank-Level-Sensor-Sheet
Tank-Level-Sensor-Sheet.SchDoc
GND
RDY-TANK-LVL

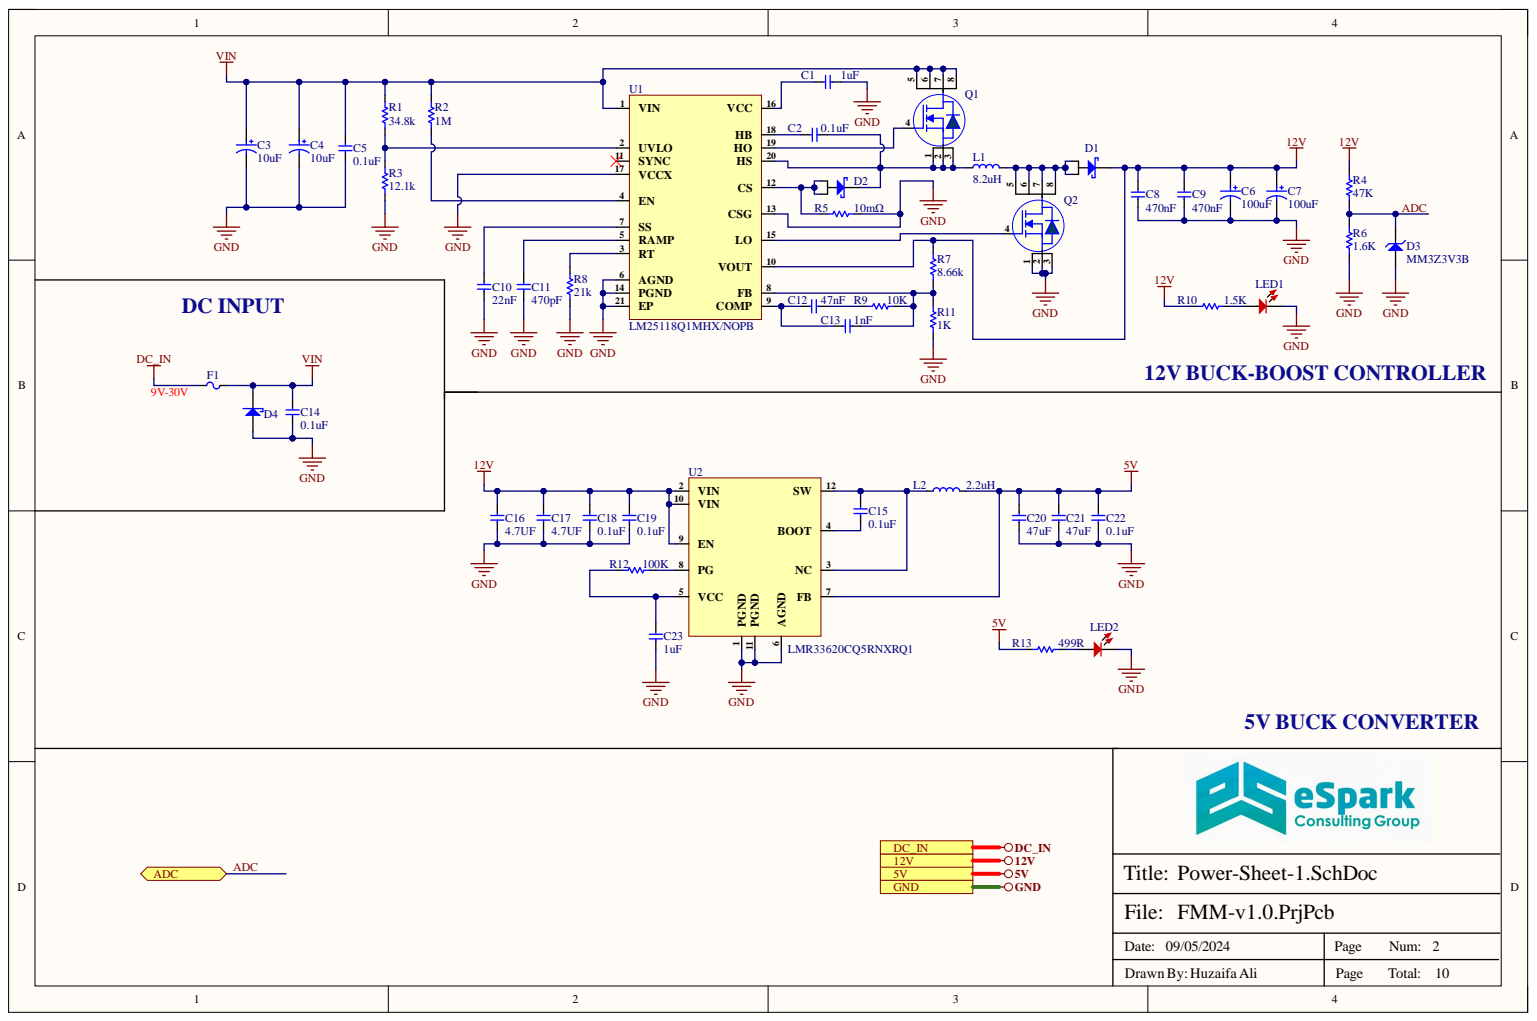
[picture p32: page 2]

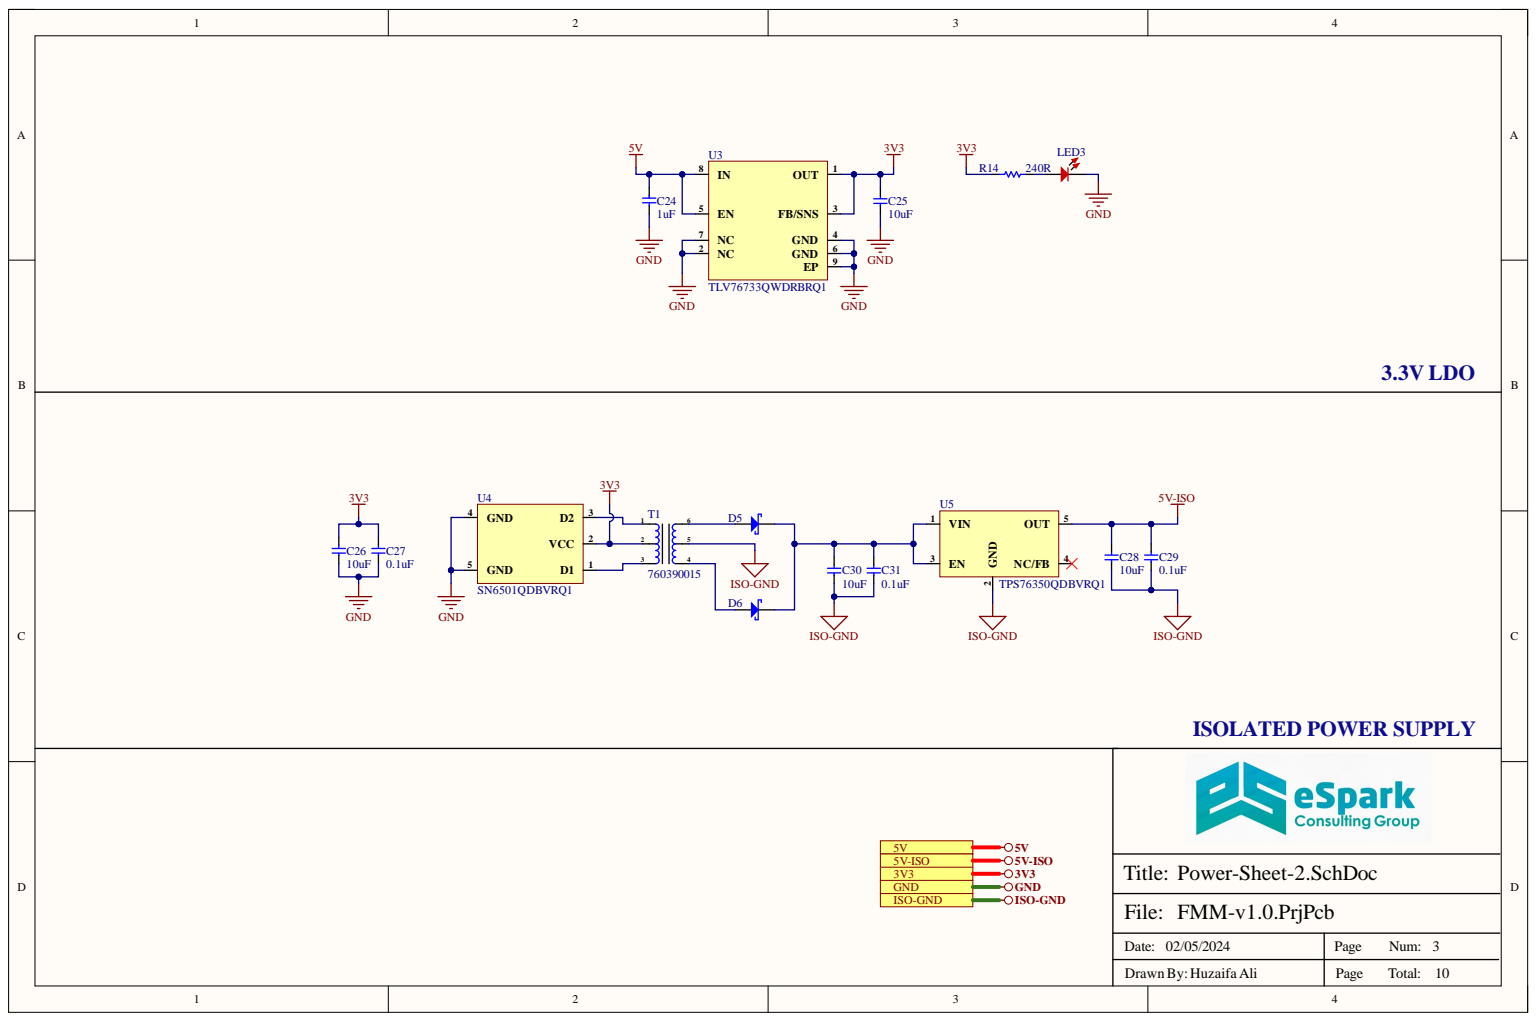
[picture p33: page 3]

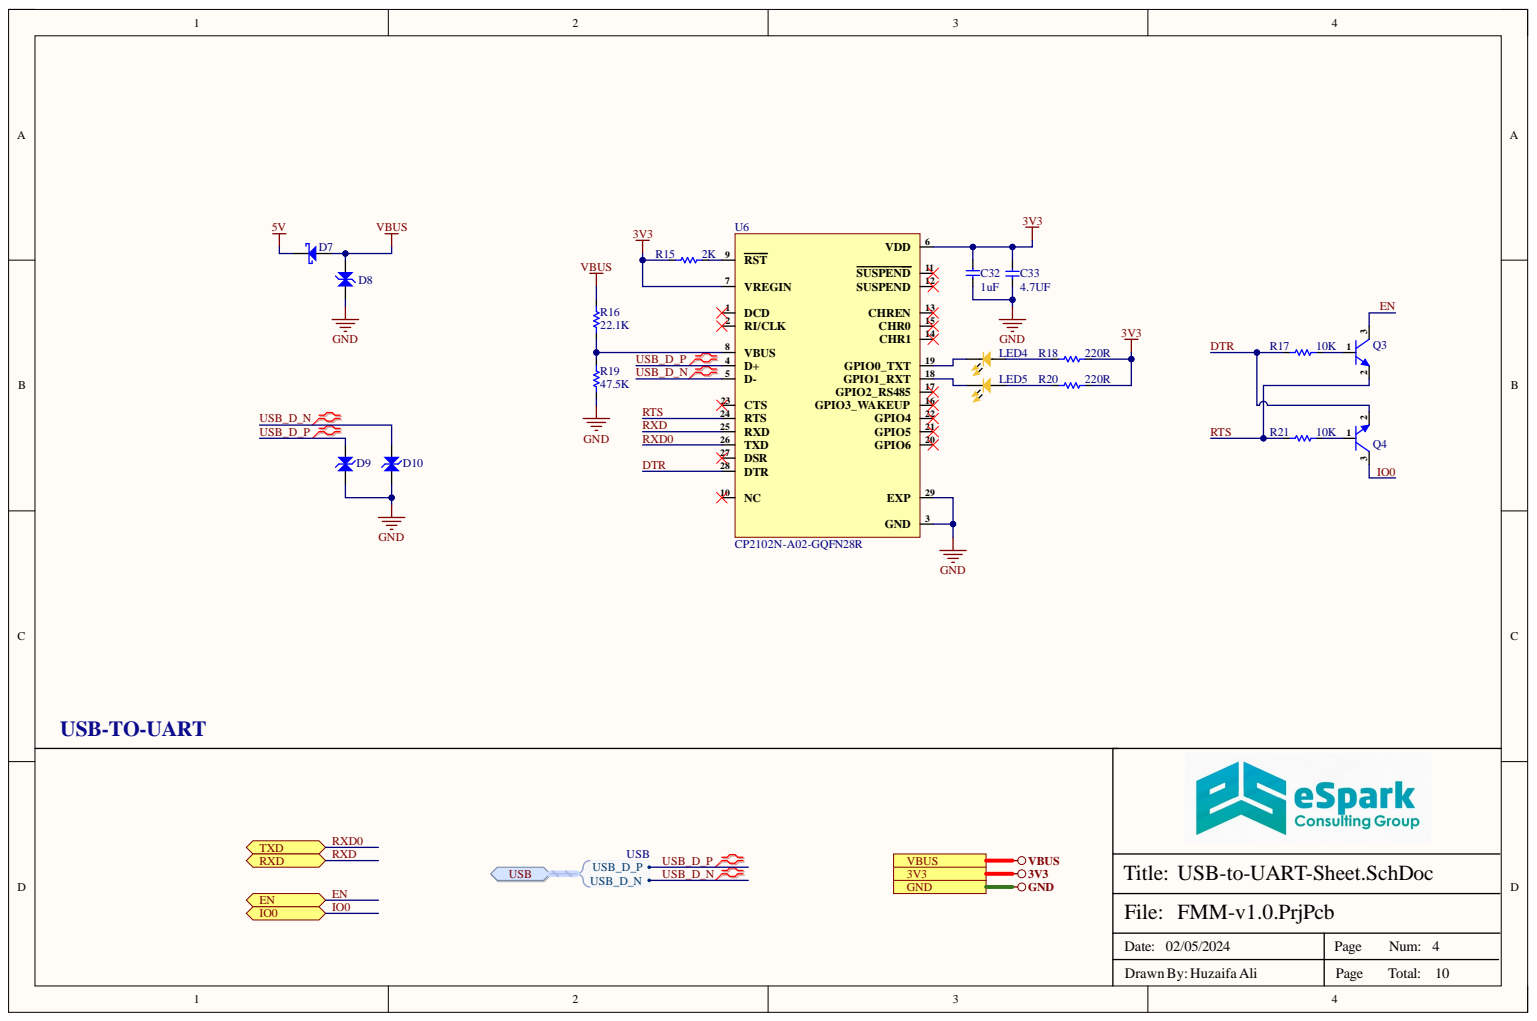
[picture p34: page 4]

USB-to-UART-Sheet.SchDoc

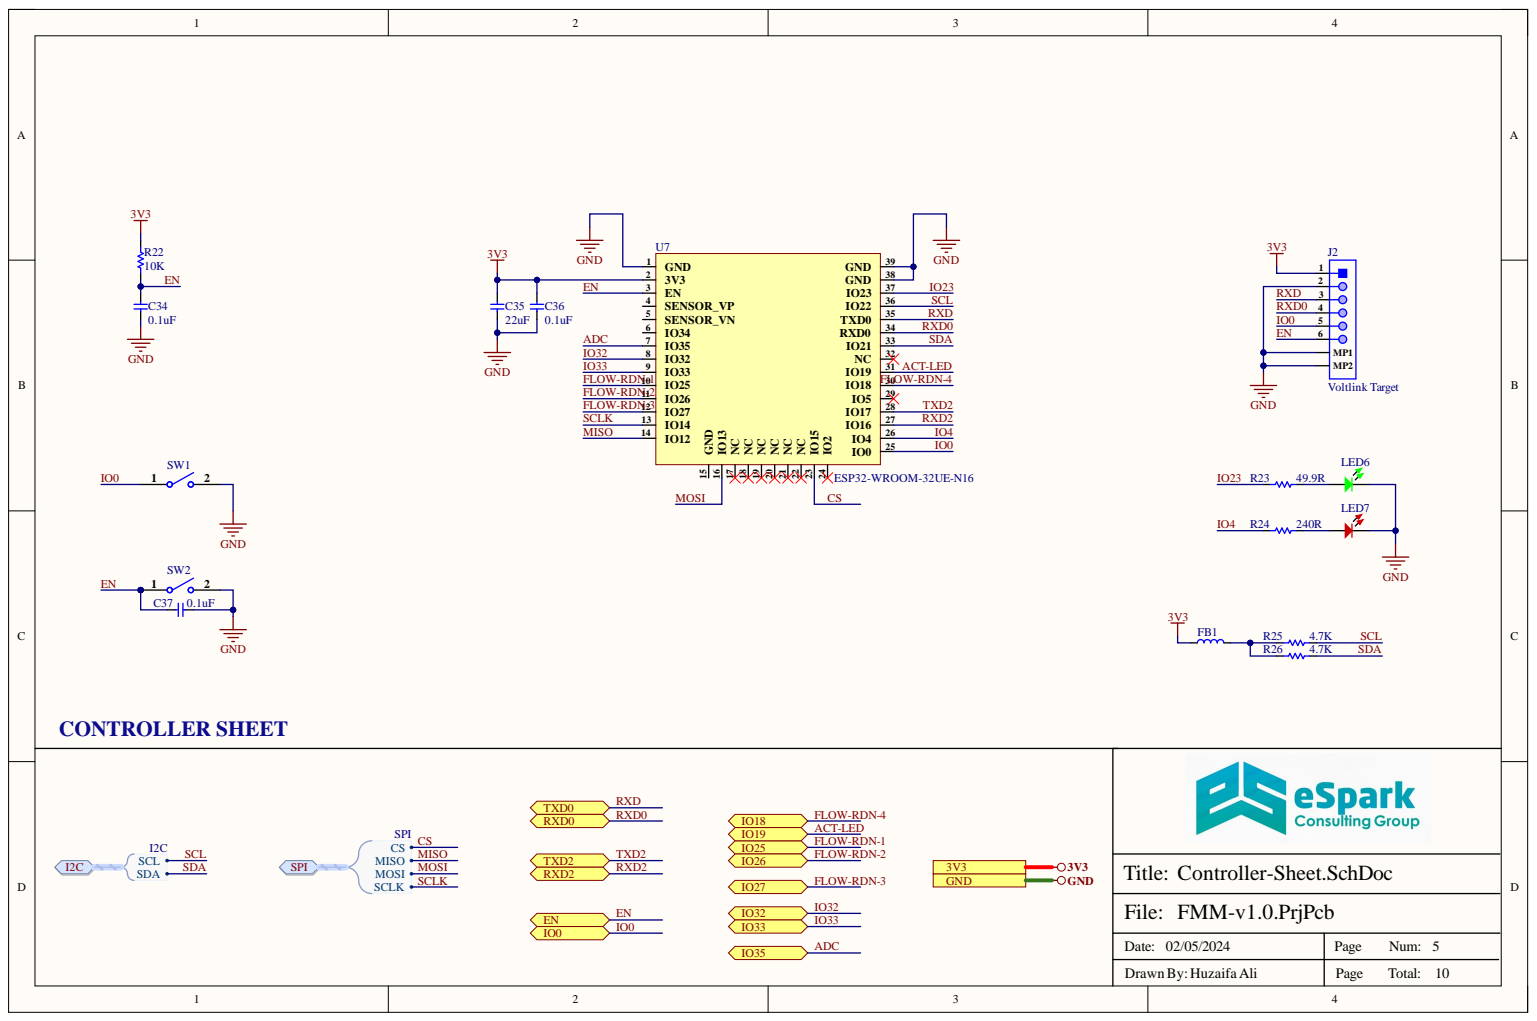
[picture p35: page 5]

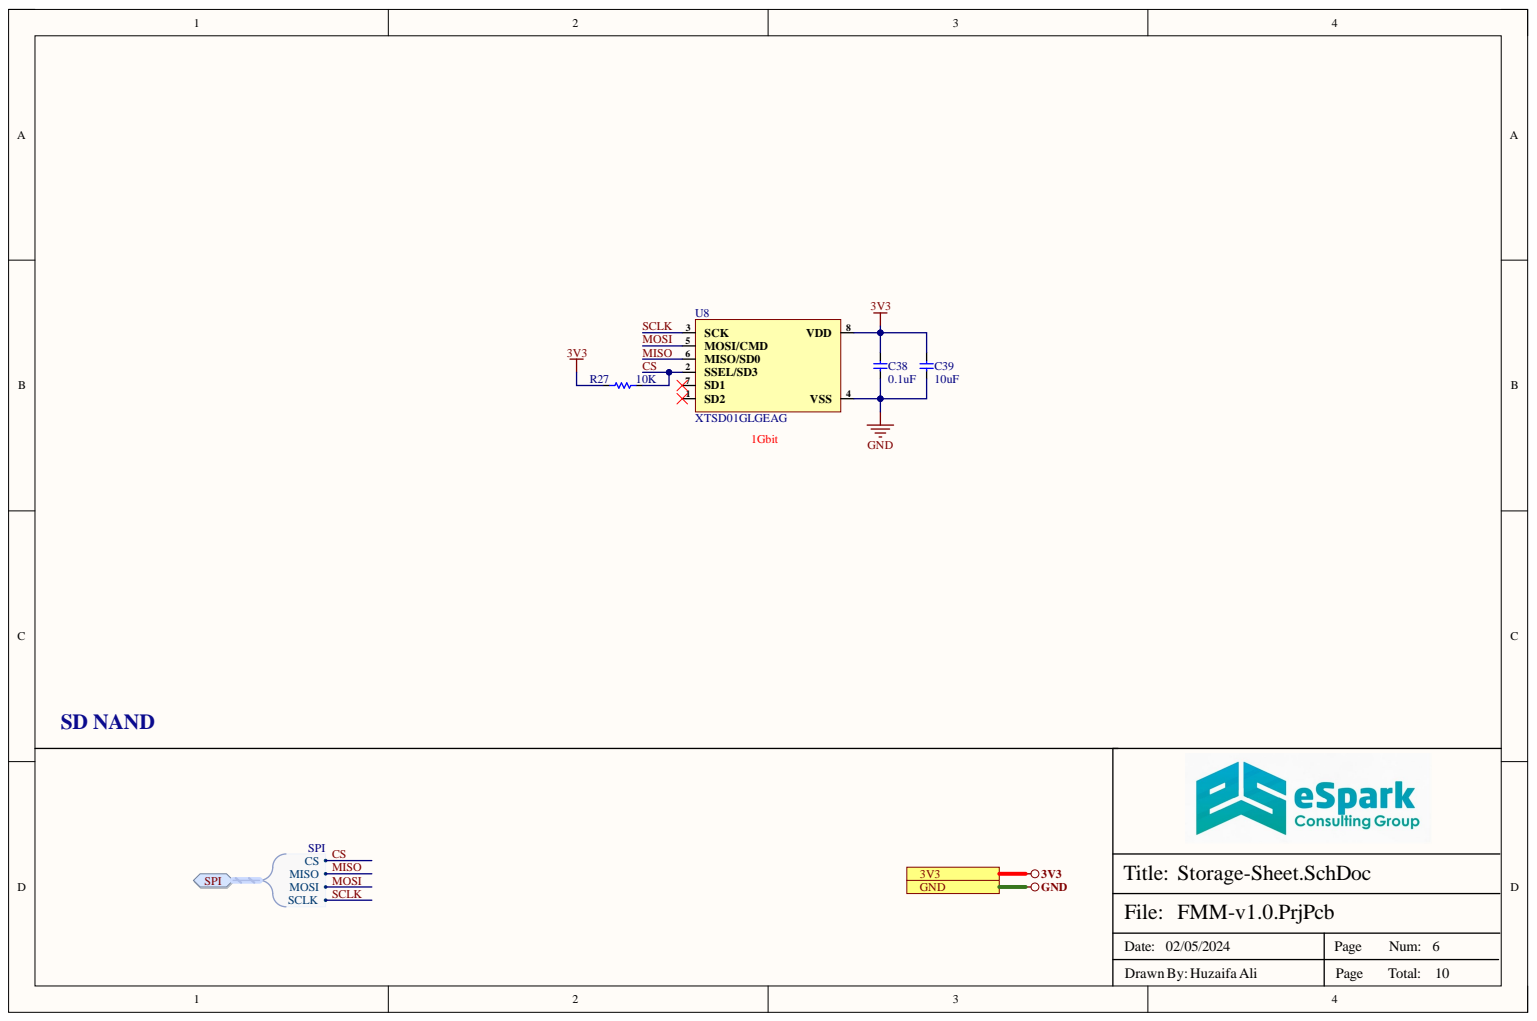
[picture p36: page 6]

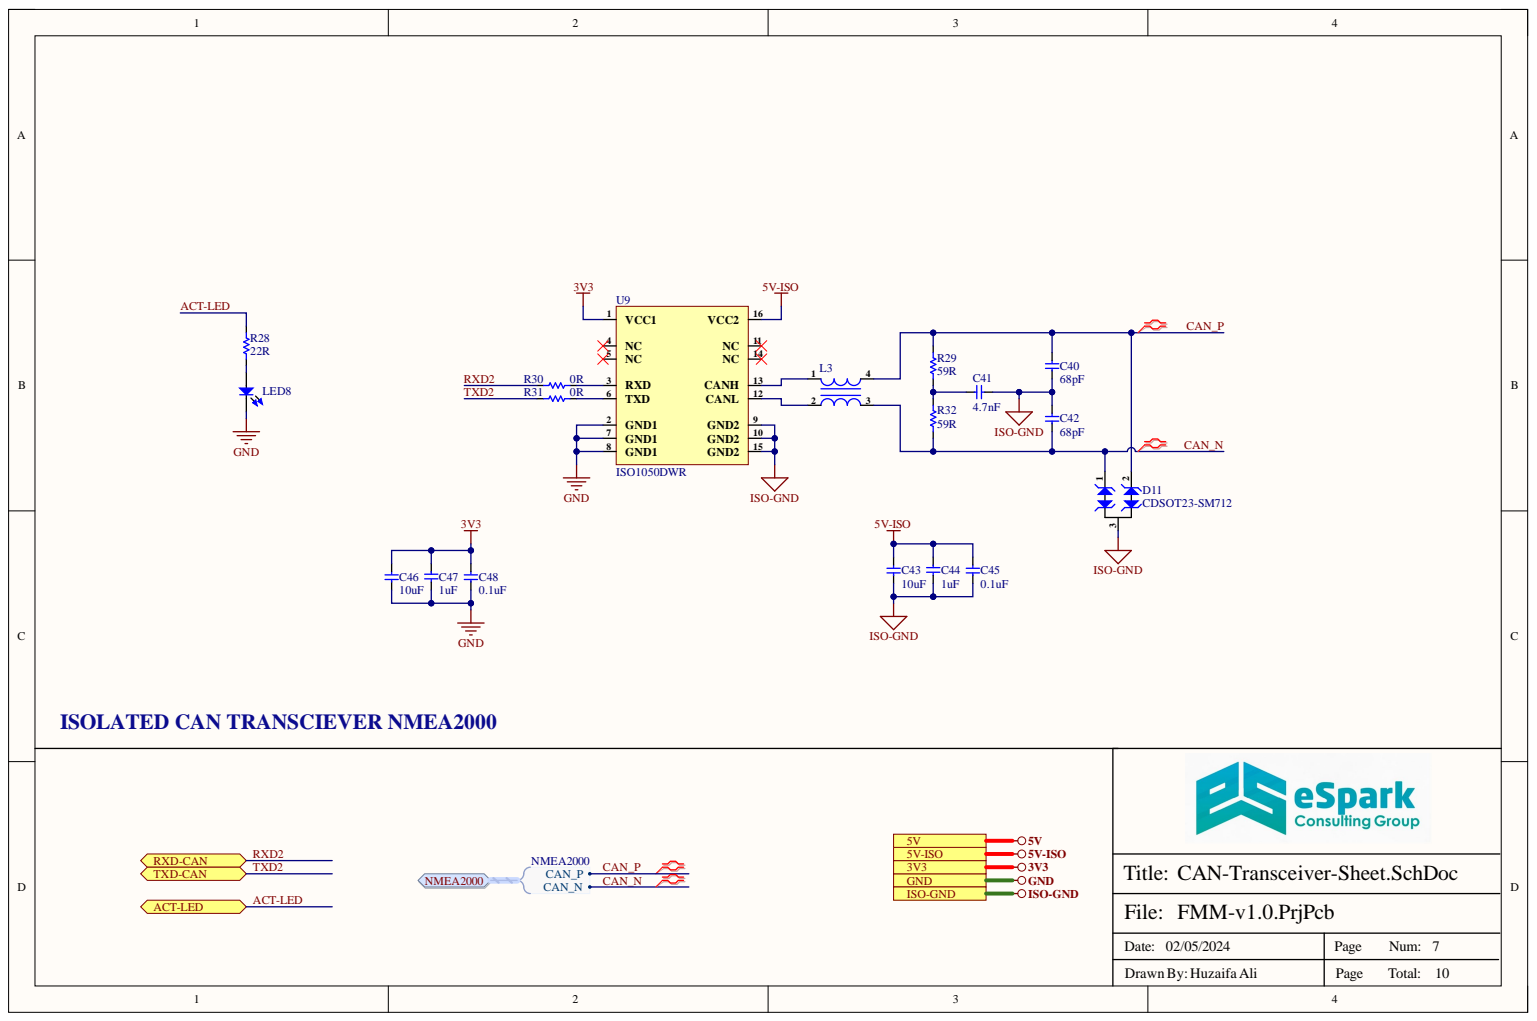
[picture p37: page 7]

CAN-Transceiver-Sheet.SchDoc

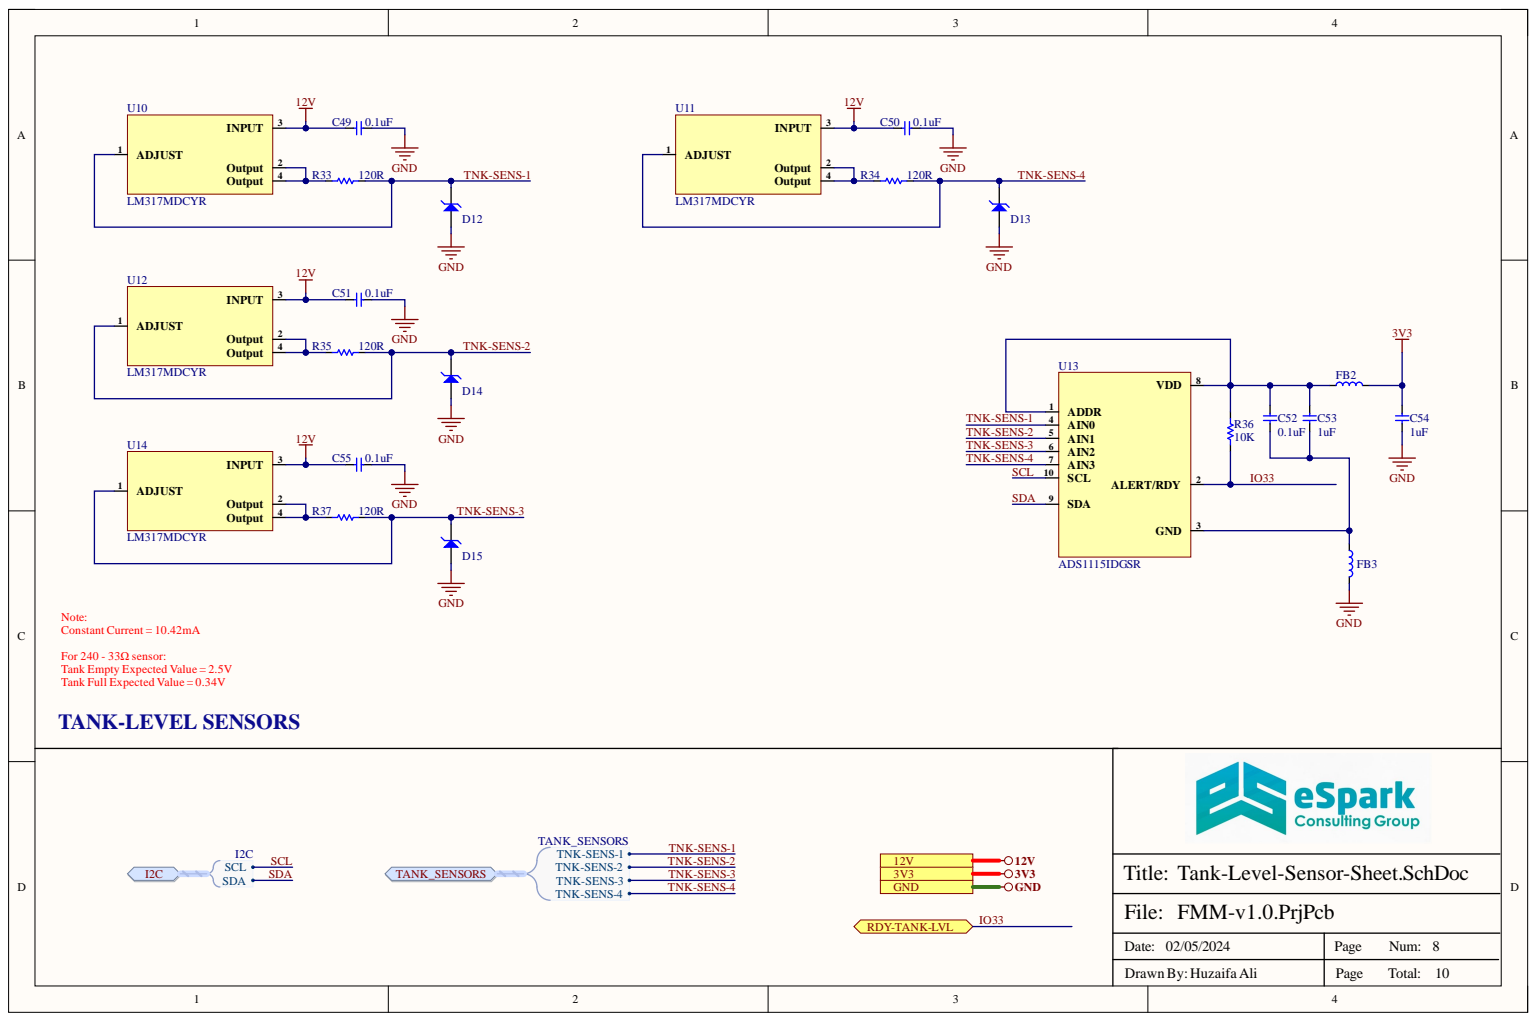
[picture p38: page 8]

For 240 - 33Ω sensor:
Tank Empty Expected Value = 2.5V
Tank Full Expected Value = 0.34V
TANK-LEVEL SENSORS

Tank-Level-Sensor-Sheet.SchDoc

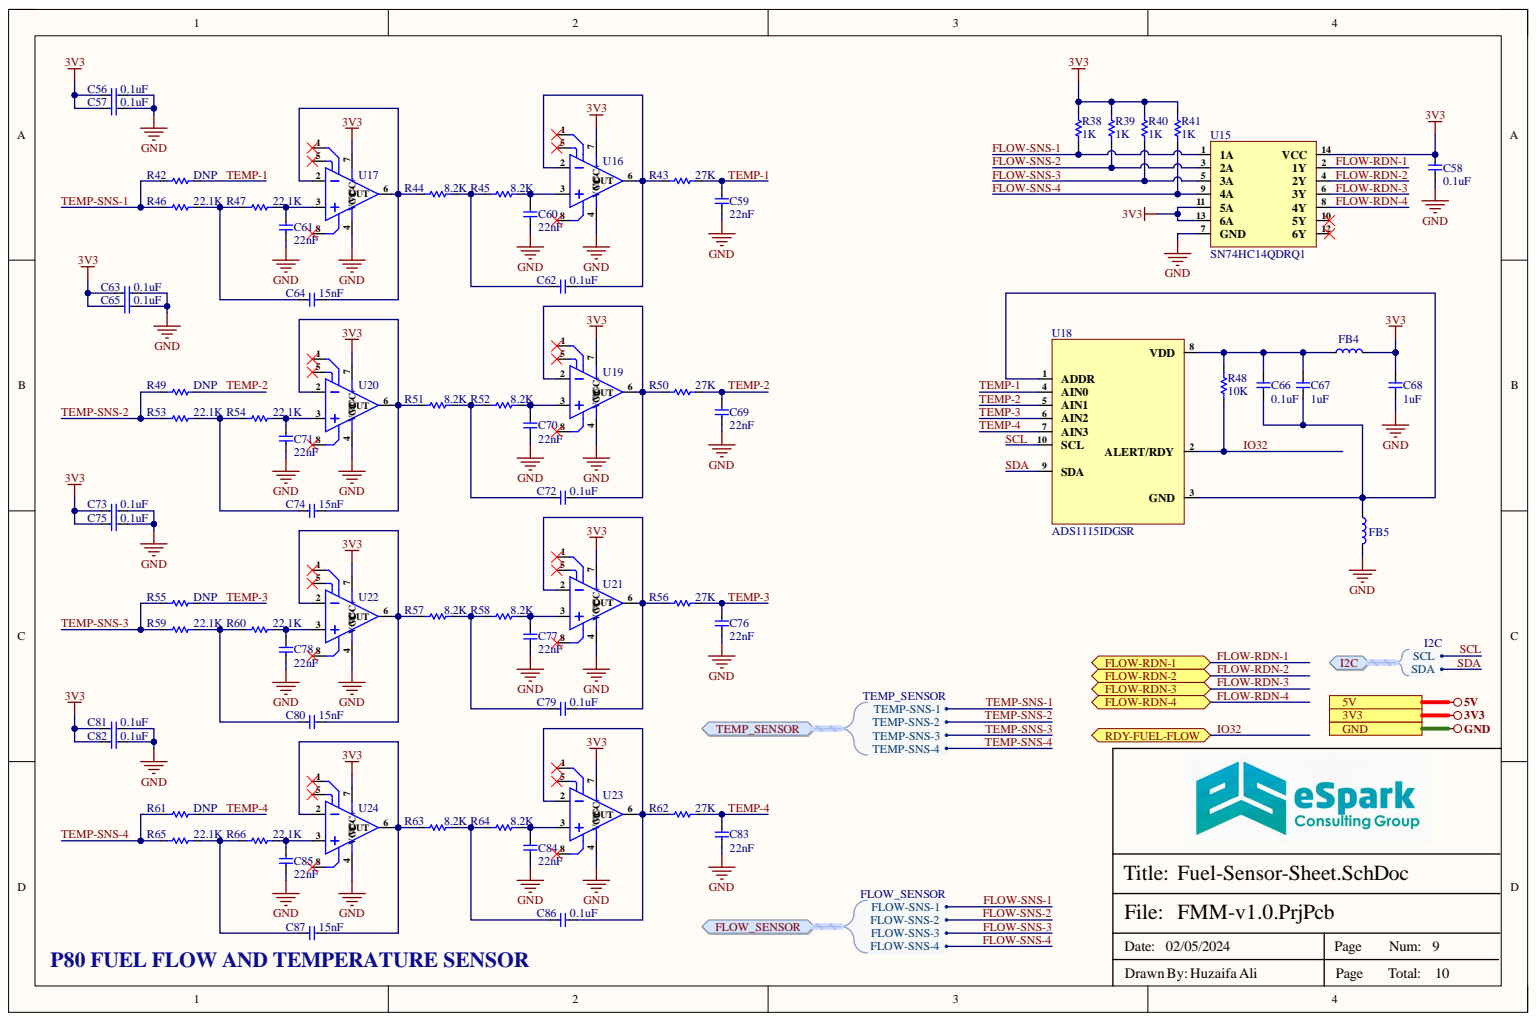
[picture p39: page 9]

0 FUEL FLOW AND TEMPERATURE SENSOR

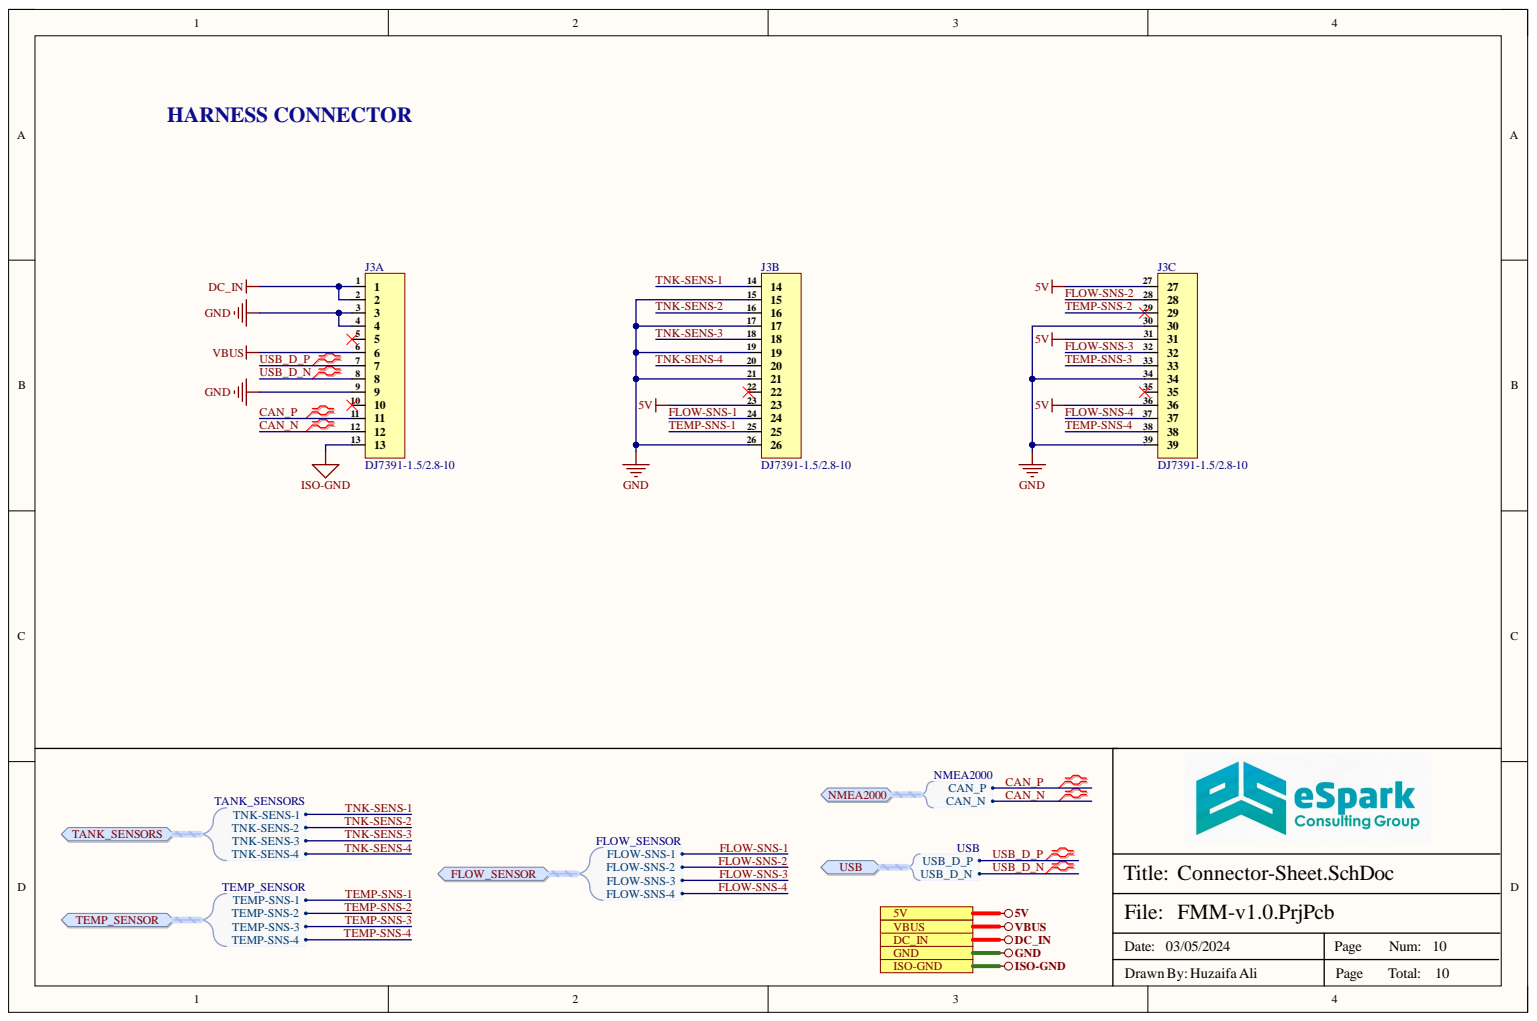
[picture p40: page 10]

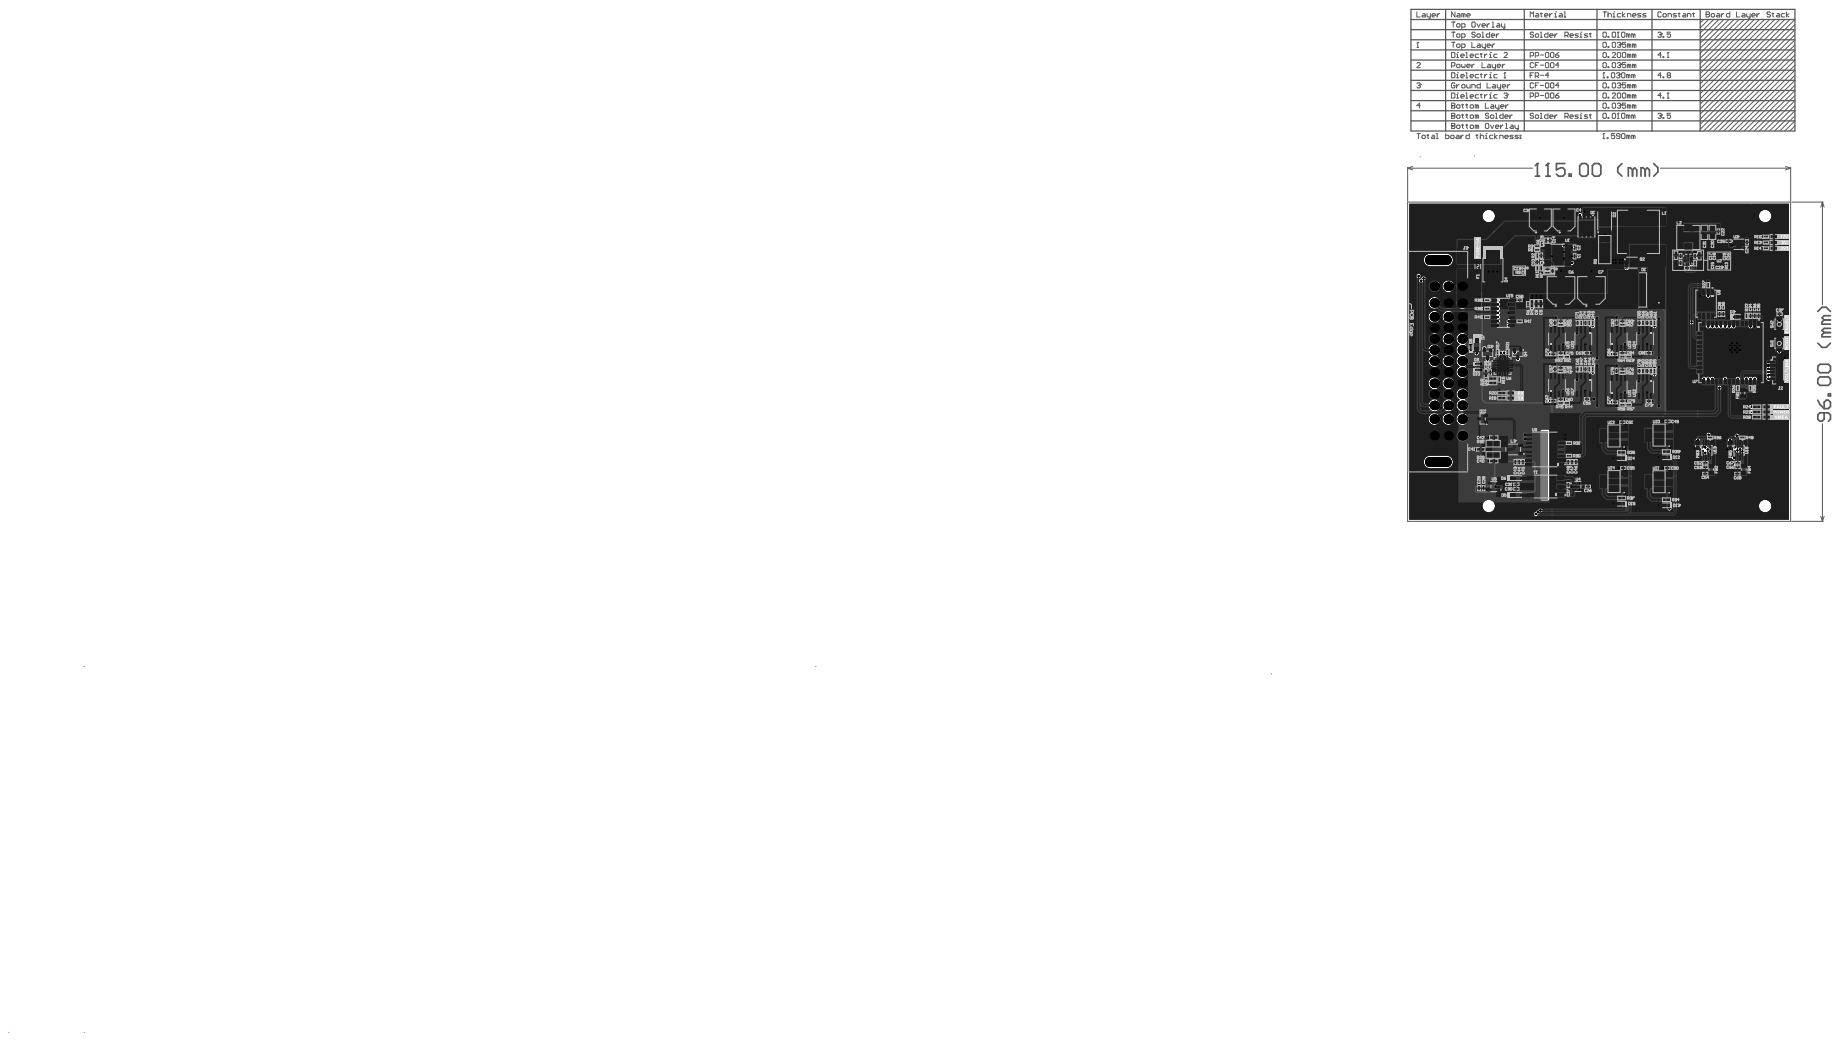
[picture p41: page 11]
