eSpark-Consulting-Group/johncox-fmmdesign/Design-Files/FMM-v1.0/Schematics/Assembly_Drawings-v1.0.pdf

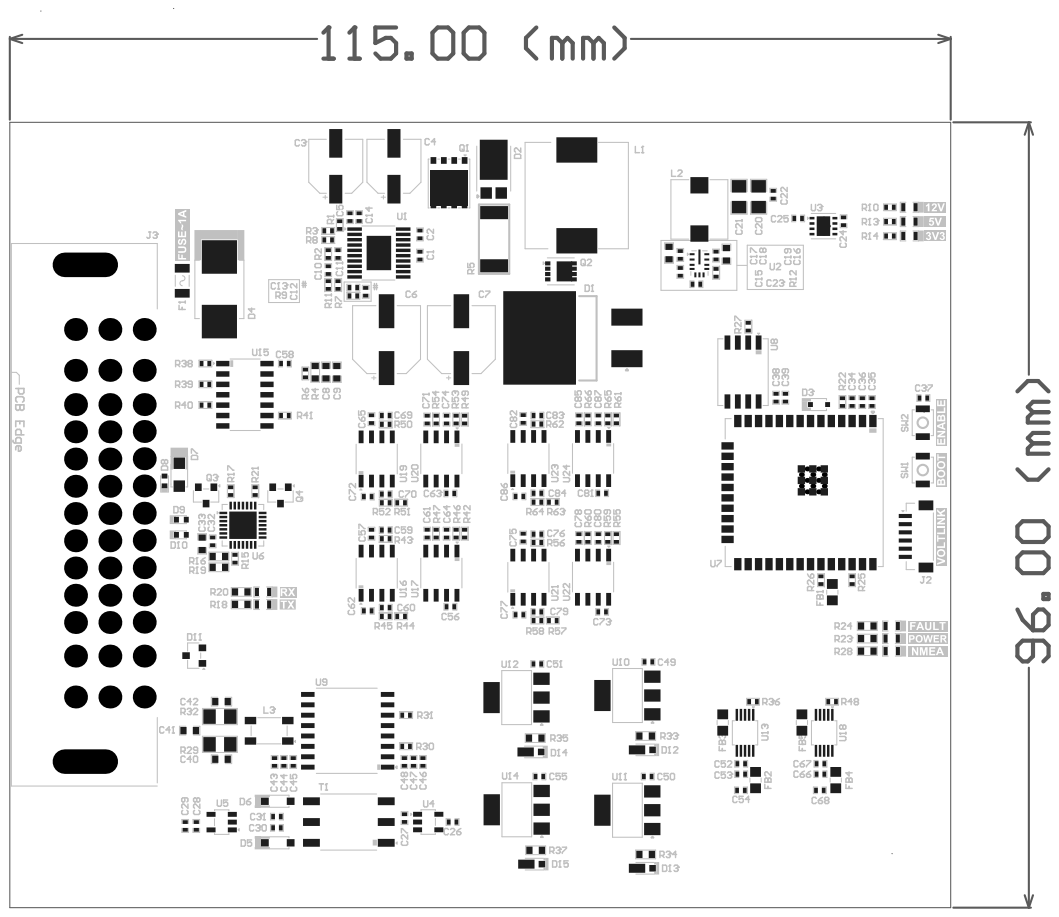
[picture p42: page 1]

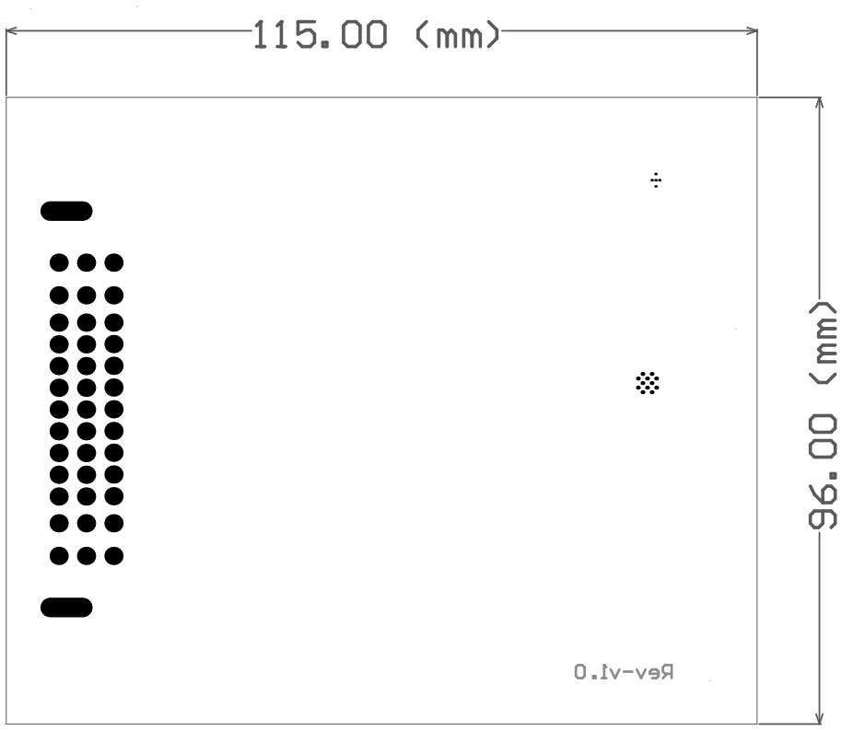
[picture p43: figure]
