eSpark-Consulting-Group/johncox-fmmdesign/(list of files, drawings)

Other design files:
Design-Files/FMM-v1.0/CAN-Transceiver-Sheet.SchDoc
Design-Files/FMM-v1.0/Connector-Sheet.SchDoc
Design-Files/FMM-v1.0/Controller-Sheet.SchDoc
Design-Files/FMM-v1.0/FMM-v1.0.PcbDoc
Design-Files/FMM-v1.0/FMM-v1.0.PrjPcb
Design-Files/FMM-v1.0/Fuel-Sensor-Sheet.SchDoc
Design-Files/FMM-v1.0/Power-Sheet-1.SchDoc
Design-Files/FMM-v1.0/Power-Sheet-2.SchDoc
Design-Files/FMM-v1.0/Storage-Sheet.SchDoc
Design-Files/FMM-v1.0/Tank-Level-Sensor-Sheet.SchDoc
Design-Files/FMM-v1.0/Top-Sheet.SchDoc
Design-Files/FMM-v1.0/USB-to-UART-Sheet.SchDoc
docs/Enclosure Files/2.PcbDoc
docs/Enclosure Files/3.PcbDoc
