eSpark-Consulting-Group/johncox-fmmdesign/(commit log)

2024-01-24 #2 Power Sheets added. 2/6 Completed
2024-01-28 #2 USB, Controller, Tank Level sensor sheets added. 4/7 Done
2024-01-31 #2 USB Connector, NMEA 2000 Connector updated. PDF Updated.
2024-01-31 #3 Client BOM Added
2024-02-02 #3 Client BOM Updated.
2024-03-01 #5 PCB Design Completed. Finishing is in progress
2024-03-06 #5 PCB Completed
2024-03-06 #3 Client BOM update Acc To #5.
2024-03-11 #2 Noise filter added on P80 Temperature sensor line
2024-03-14 #5 Modifications are completed into the PCB Design
2024-03-21 #2 USB connector Shell pins disconnected from GND. Added the necessary RC combination for ESD.
2024-03-21 #4 Client BOM Updated Acc to #2.
2024-03-21 #3 Updated BOM.
2024-03-25 #3 Updated Client BOM!
2024-03-27 #5 Changes in PCB against shell pins done: MH adjustments Remaining.
2024-03-27 Enclosure folder added in docs folder.
2024-03-28 #5 Changes in PCB in-progress.
2024-03-29 #5 PCB Completed with zero DRC Errors.
2024-04-01 Pushed client BOM (without pricing)
2024-04-24 Enclosure catalogs pushed; minor folder location updates
2024-05-02 #2 #6 Connector added in the sheet. NMEA2000 connector removed. Connections transferred. PDF updated
2024-05-03 #6 #2 Connector pinout updated according to client request. PDF updated
2024-05-03 #3 Client and eSpark BOM updated.
2024-05-03 #6 #2 Fuse and TVS changed. PDF Updated
2024-05-06 #3 Client and eSpark BOM update acc to current Schematic.
2024-05-09 Connector format made according to client's request
2024-05-10 #5 Footprint updated and Fresh Deliverables Updated
